tinkerius/brewberrypi-case/04-stl/README.md

# STL output

Generated by `tools/build.sh` from `03-openscad/brewberrypi-case.scad`. Do not edit by hand.
Checked by `tools/check.sh`. Full output: [check-report.txt](check-report.txt).

Built from spec version: **0.21** (2026-11-04: after the first print: jack hole Ø8.4 → Ø7.9, rocker switch cutouts MAIN 21 × 28.5, HEATER/PUMP 21.5 × 30. 2026-10-27: new brand: labels in Zilla Slab Bold, stacked brand logo centred on the top lid. 2026-10-23: all bought parts measured; M2.5 inserts for the circuit boards; adapter on 4 standoffs; Pi centred and turned: GPIO to the outer wall, USB/Ethernet back, SD card front; relay board in its original orientation under it).

## Files

| File | Part | Size (mm) | Print orientation (as exported) |
|---|---|---|---|
| [brewberrypi-case-body.stl](brewberrypi-case-body.stl) | body | 190 × 160 × 123 (+0.6 labels front/back) | upright, bottom edge on the bed |
| [brewberrypi-case-divider.stl](brewberrypi-case-divider.stl) | divider plate | 183.4 × 153.4 × 13 | upside down, standoffs and brackets pointing up |
| [brewberrypi-case-top_lid.stl](brewberrypi-case-top_lid.stl) | top lid | 186.6 × 156.6 × 3.8 | inner face on the bed, logo up (+0.8 logo) |
| [brewberrypi-case-bottom_lid.stl](brewberrypi-case-bottom_lid.stl) | bottom lid | 190 × 160 × 7 | outer face on the bed, lip up |

All parts are designed to print **without supports** in one filament. Everything else (material, layer height,
infill, …) is up to your slicer. Bought parts: see spec §7 (M3 inserts 3 × 6 × 4.5 + M3 screws for the case, M2.5 inserts 2.5 × 5 × 3.5 + M2.5 screws
for the Pi and relay board, brass M2.5 M/F Pi standoffs, 2 × M3 × 30 for the adapter, 4 rubber feet).

## Previews

| | iso (front) | iso (back) | top | front |
|---|---|---|---|---|
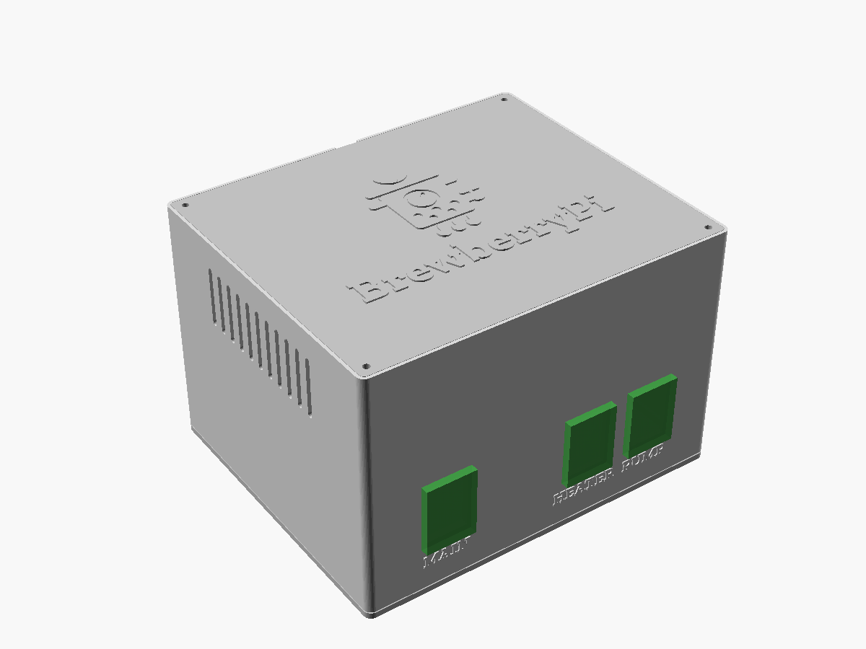
[picture p1: 04-stl/previews/assembly-iso.png]
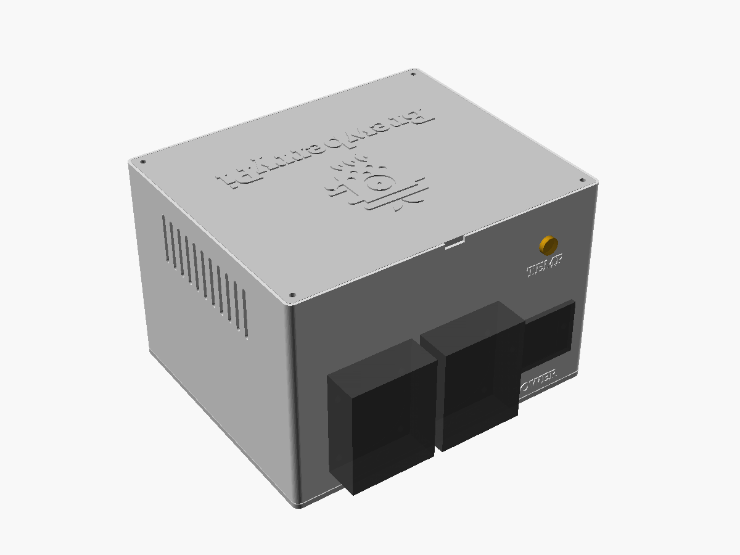
[picture p2: 04-stl/previews/assembly-iso-back.png]
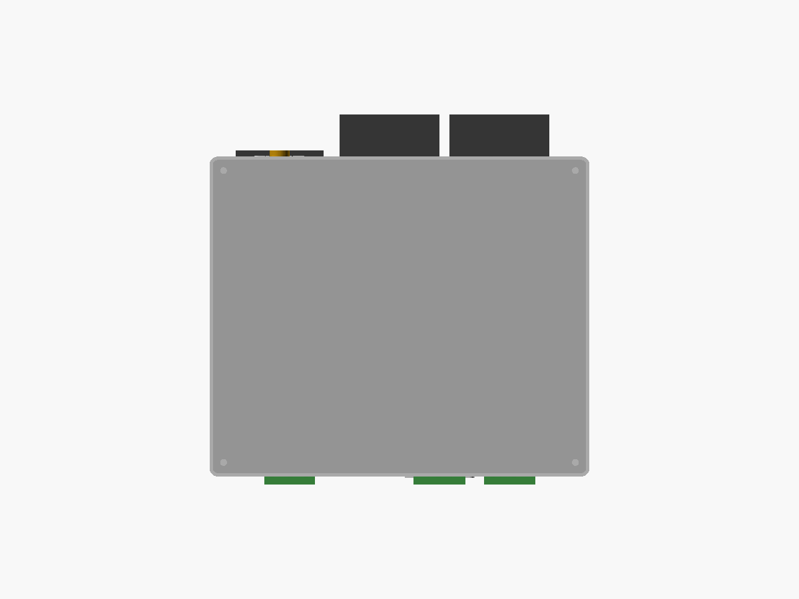
[picture p3: 04-stl/previews/assembly-top.png]
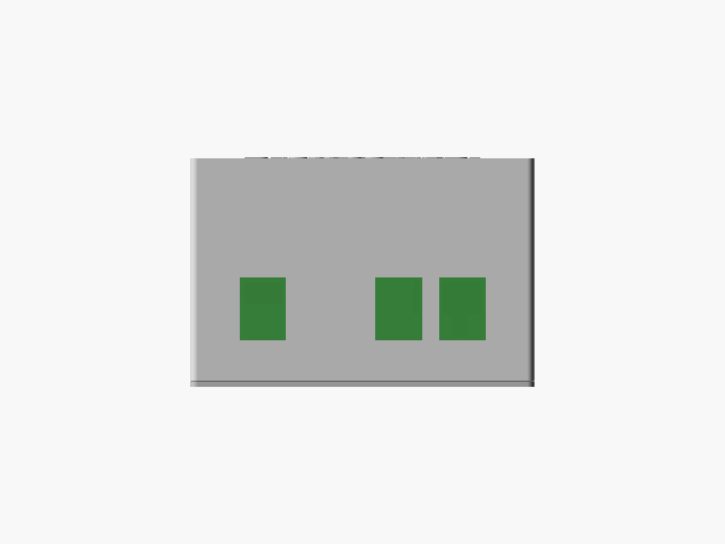
[picture p4: 04-stl/previews/assembly-front.png]
| assembly |  |  |  |  |
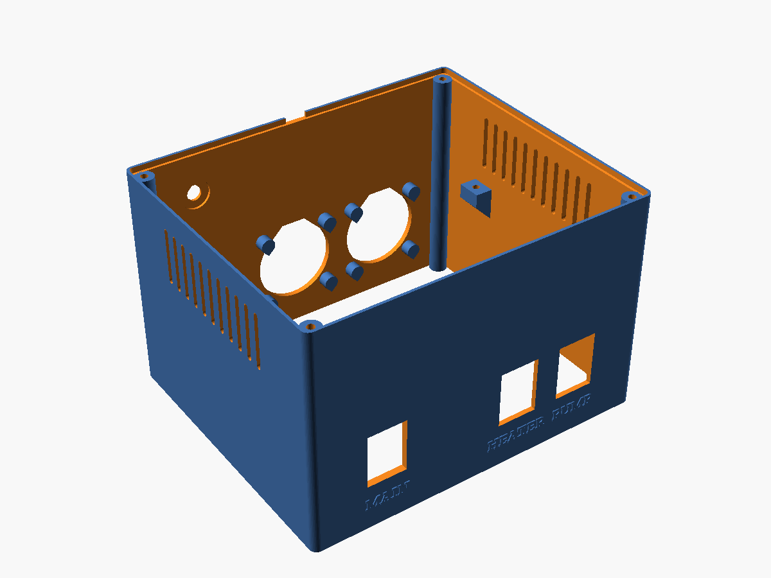
[picture p5: 04-stl/previews/body-iso.png]
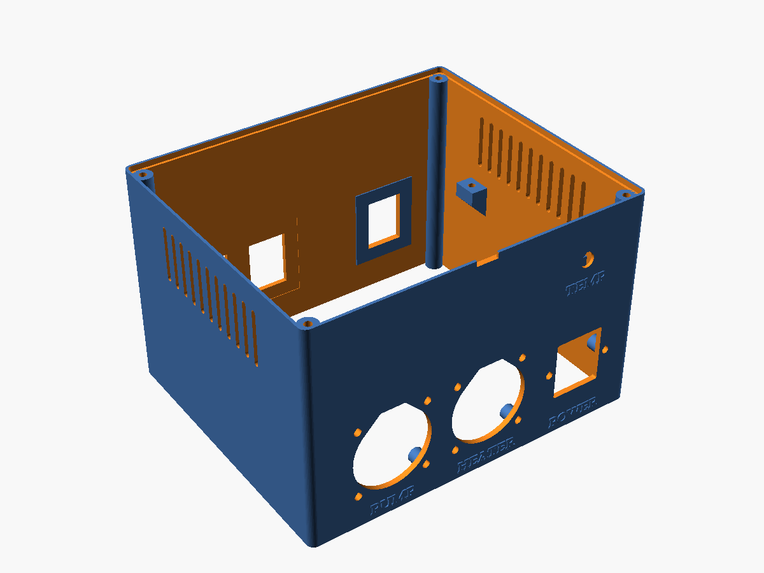
[picture p6: 04-stl/previews/body-iso-back.png]
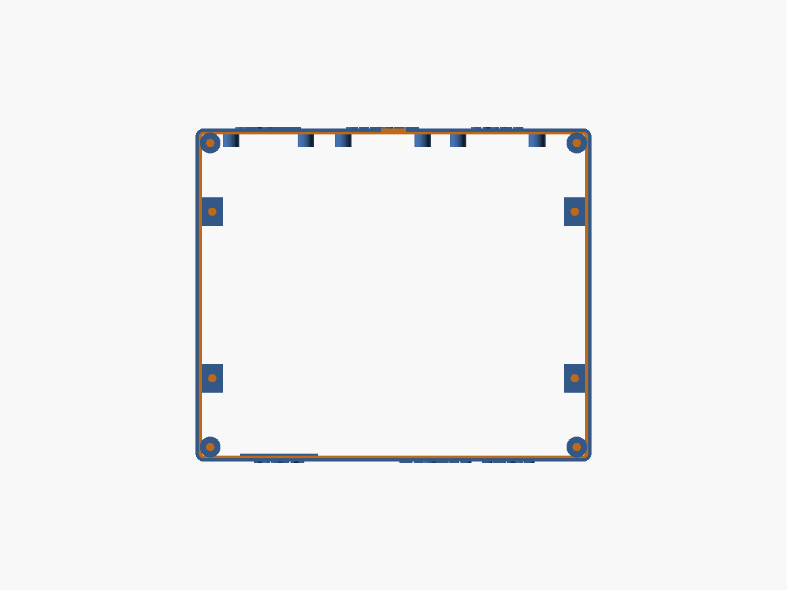
[picture p7: 04-stl/previews/body-top.png]
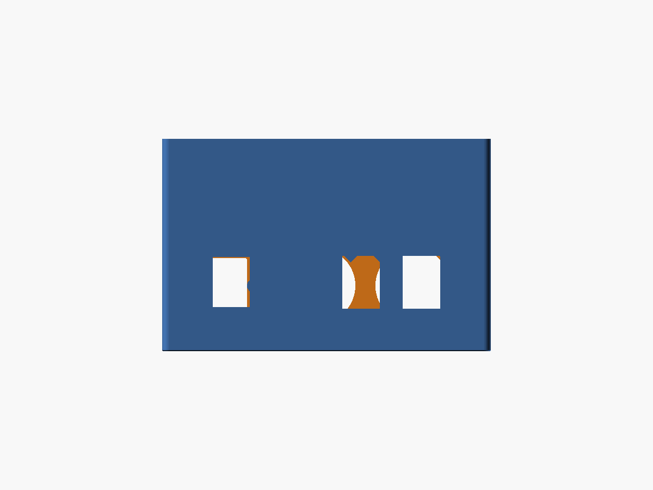
[picture p8: 04-stl/previews/body-front.png]
| body |  |  |  |  |
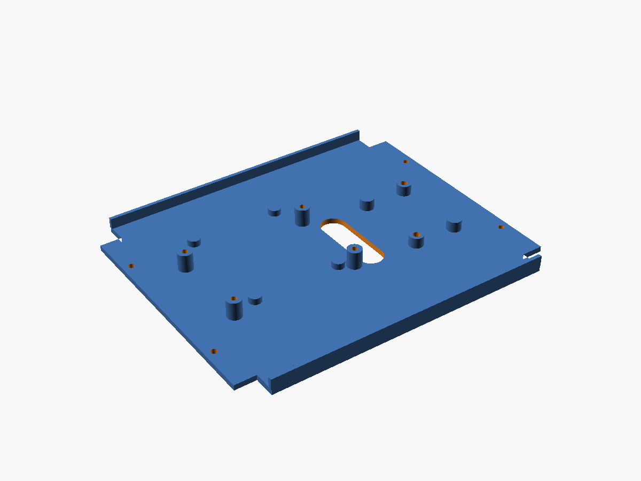
[picture p9: 04-stl/previews/divider-iso.png]
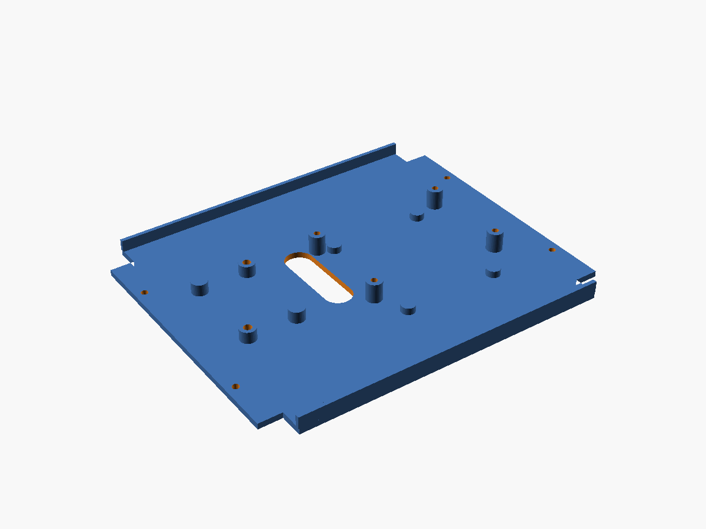
[picture p10: 04-stl/previews/divider-iso-back.png]
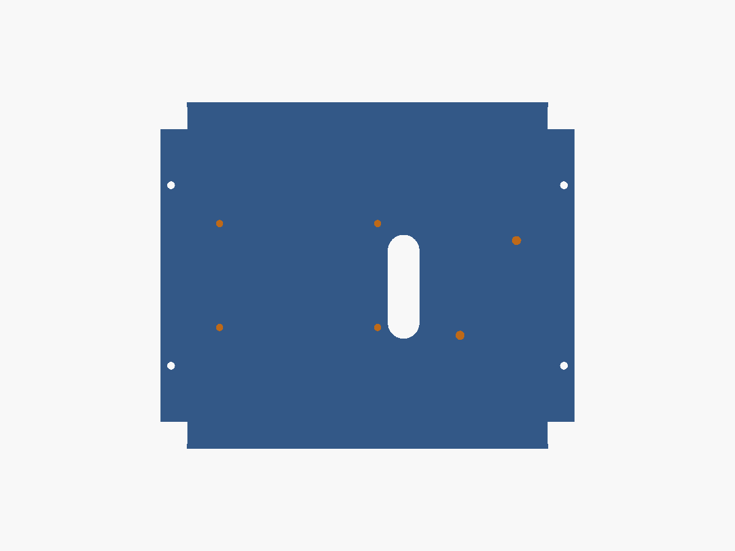
[picture p11: 04-stl/previews/divider-top.png]
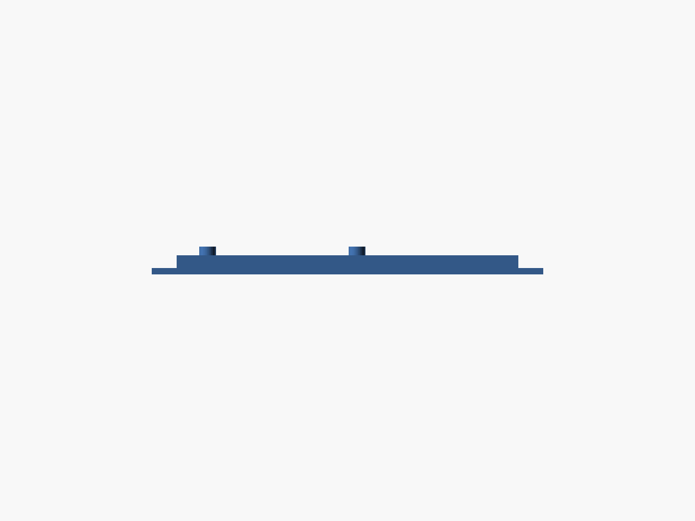
[picture p12: 04-stl/previews/divider-front.png]
| divider |  |  |  |  |
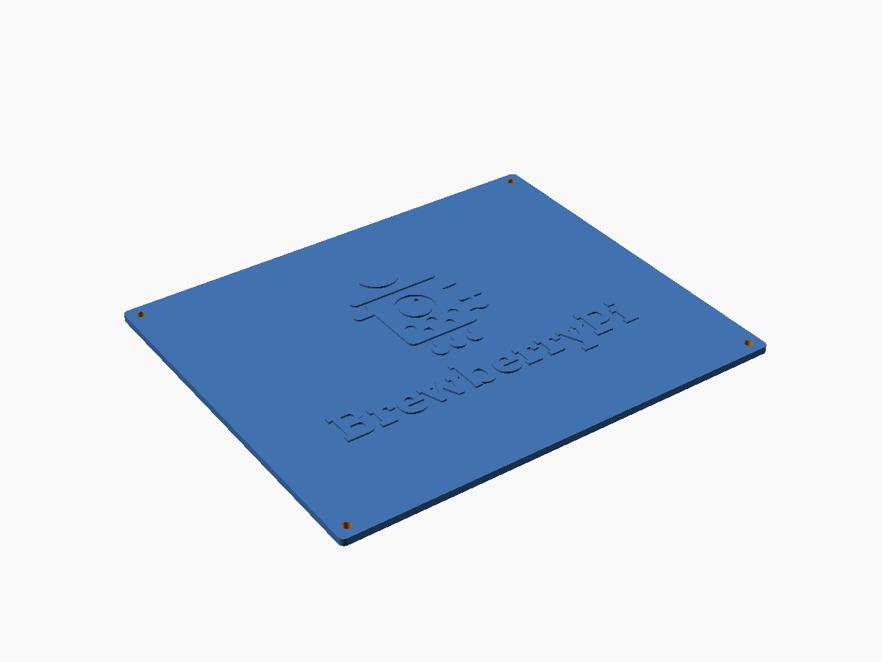
[picture p13: 04-stl/previews/top_lid-iso.png]
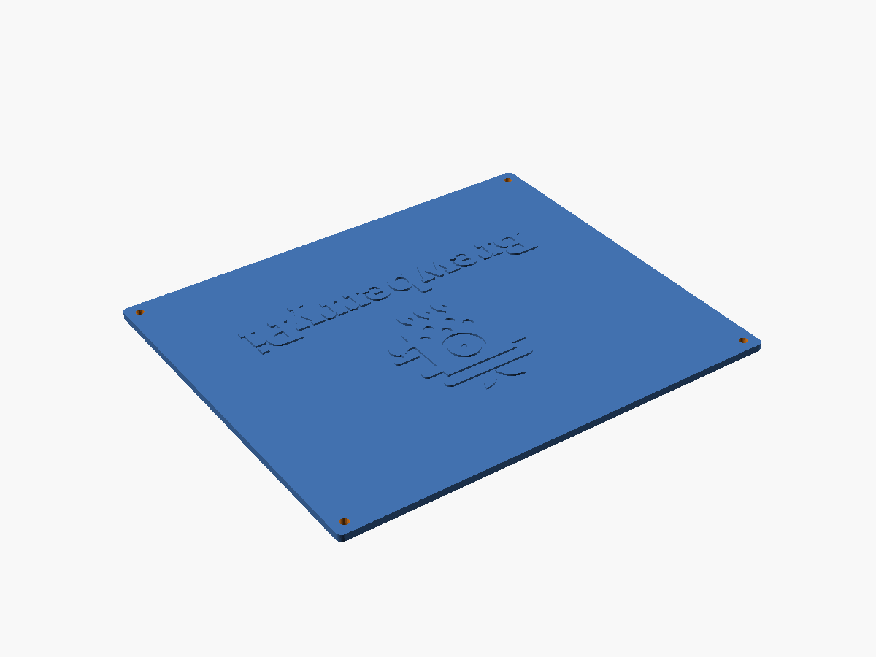
[picture p14: 04-stl/previews/top_lid-iso-back.png]
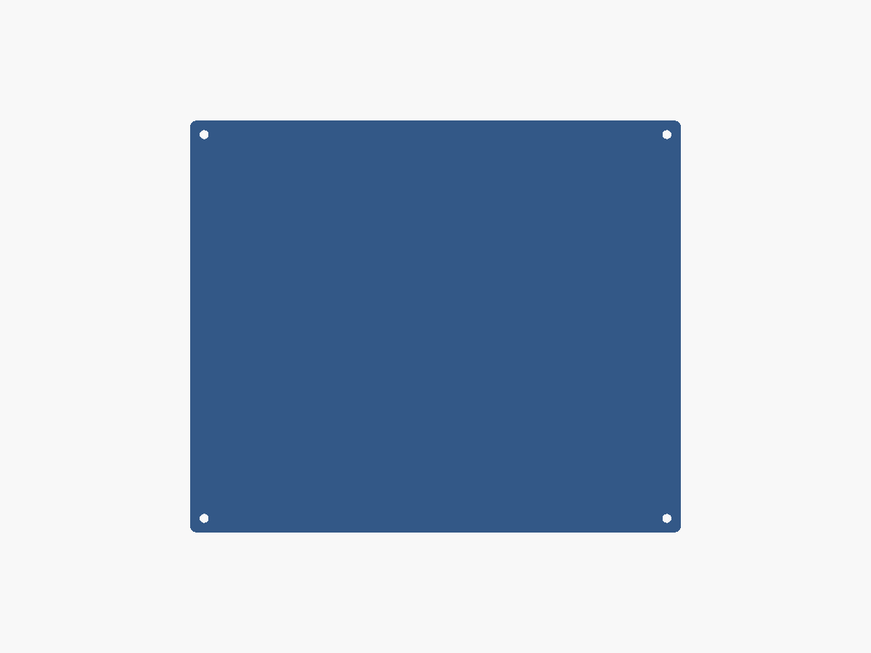
[picture p15: 04-stl/previews/top_lid-top.png]
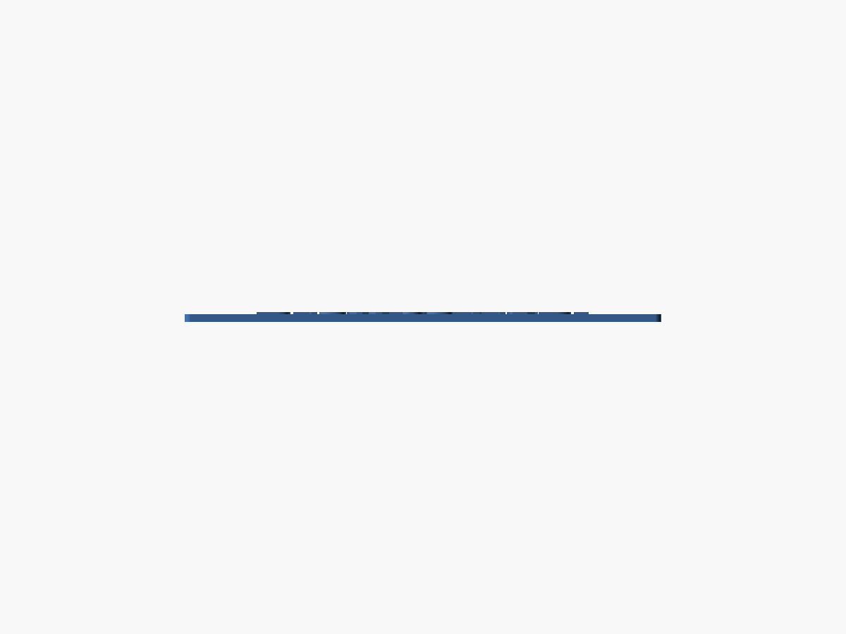
[picture p16: 04-stl/previews/top_lid-front.png]
| top lid |  |  |  |  |
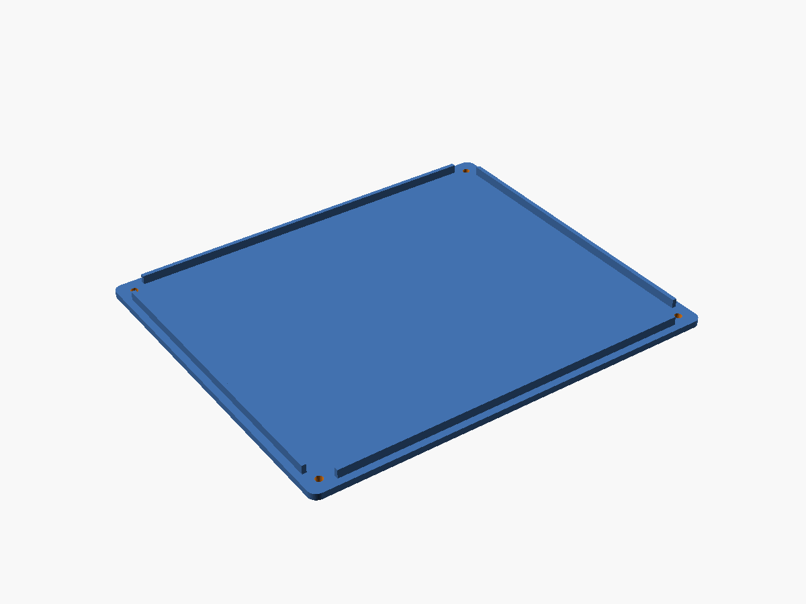
[picture p17: 04-stl/previews/bottom_lid-iso.png]
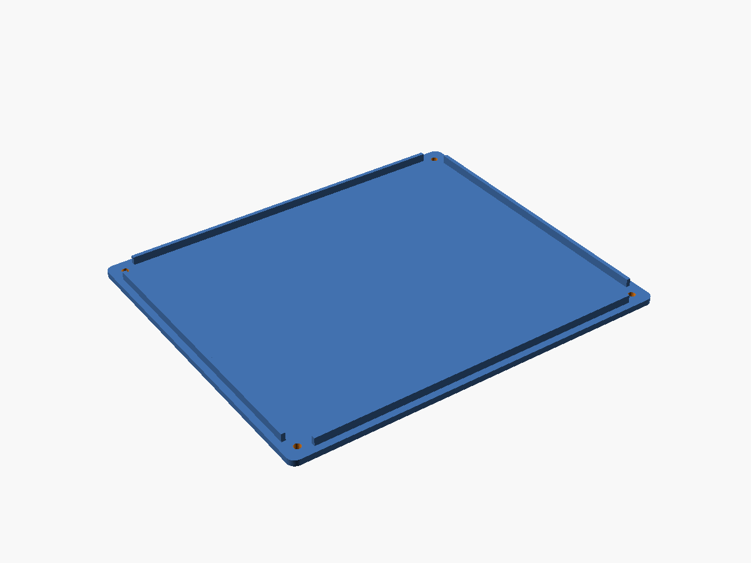
[picture p18: 04-stl/previews/bottom_lid-iso-back.png]
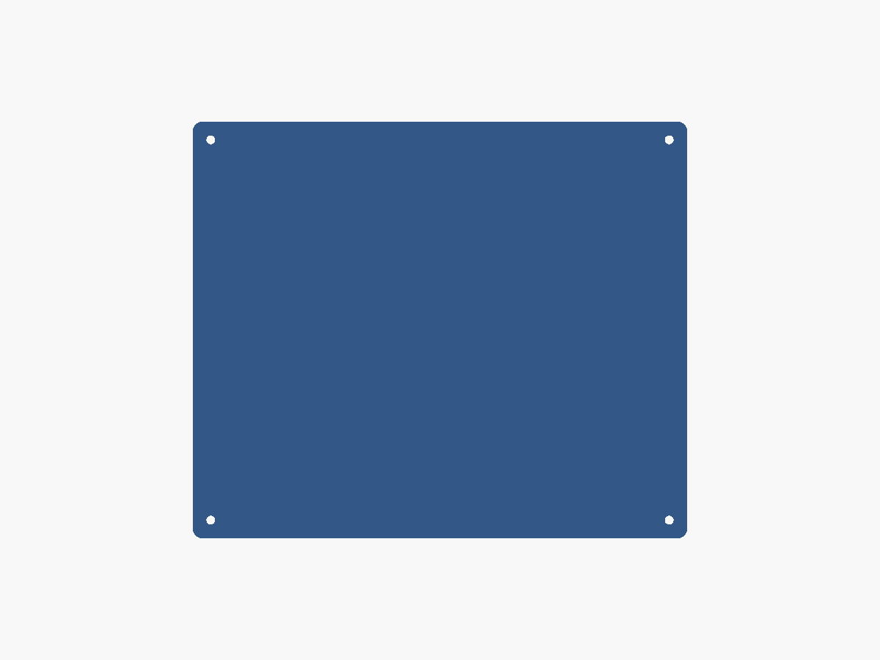
[picture p19: 04-stl/previews/bottom_lid-top.png]
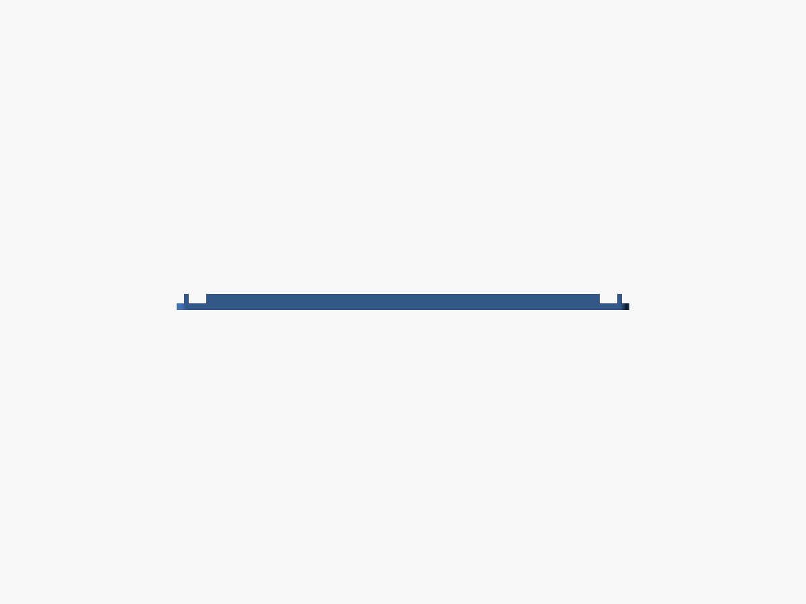
[picture p20: 04-stl/previews/bottom_lid-front.png]
| bottom lid |  |  |  |  |

## Verification (spec §9)

| AC | Criterion | Result | Evidence |
|---|---|---|---|
| AC1 | Bounding boxes ≤ 200 mm, sizes as in §1 | ✅ pass | all four sizes as in the table above (`check.sh`, admesh) |
| AC2 | Every STL manifold | ✅ pass | 1 part each, 0 degenerate facets, 0 edges fixed, 0 facets added/removed, 0 backwards edges |
| AC3 | No collision between components and printed parts | ✅ pass | `part="collision_check"` renders empty: 10 component envelopes against all printed parts and against each other (45 pairs) |
| AC4 | Cutouts as in §5 (F3, F6, F7, F8) | ✅ pass | model report: MAIN 21.4 × 28.9 (wall at the clips 3.7), HEATER/PUMP 21.9 × 30.4 (wall 2.7), the same measured on the STL's front face at x 40/115/150, z 40; IEC 27.9 × 31.9 r1 at x 35, z 38, screws 36; sockets Ø43.4 flat top at 24, HEATER x 90 / PUMP x 145, z 38, □38; jack Ø7.9 (thread 7.8 + 0.05 per side, P36; measured on the STL: 7.90 wide) flat top at 4.7, wall 1.6, at x 35, z 98; adapter on 4 standoffs: M3 inserts at (161, 64.5) and (136, 106.5), solid at (136, 64.5) and (161, 106.5), 25 × 42 apart. Seen from the top, both panels read mains, heater, pump from the left |
| AC5 | Pi pattern 58 × 49 at F11, relay pattern below | ✅ pass | Pi centred front to back, GPIO header on the left: holes (43.5/92.5, 41/99); relay board in its original orientation: holes 70 × 46 at (29.5/99.5, 57/103), under the Pi, 2 mm clear of the feed-through, standoffs separate from the Pi bosses. Collision check keeps 30 mm free at the SD card and at the USB/Ethernet ports (R23) |
| AC6 | No overhang > 45° without a bridge | ✅ pass | `overhangs.py`: body: bridges over the IEC cutout (27.9), switch cutouts (21.9/21.4), socket flat tops (13.4), jack flat top (≈1.8), insert-hole ceilings (Ø4), vent slot tops (Ø3); ledges ≤ 1.4 mm at the switch pockets/frame and the jack pocket; text undersides (0.6, now including the slab serifs: 191 tiny spots instead of 113). Divider: ceilings of the blind M2.5 insert holes (Ø3.2). Lids: none |
| AC7 | Only M3 and M2.5 fastener features | ✅ pass | code review: inserts `insert_m3` (Ø4.0 × 7, case) and `insert_m25` (Ø3.2 × 6, Pi + relay board), through holes `m3_clear` (Ø3.4) |
| AC8 | Labels raised 0.6 (logo 0.8), capitals ≥ 6 mm, all text in Zilla Slab Bold, readable from outside; logo 130 × 85.17 at (95, 80), same outline as B2 | ✅ pass | `labels.py`: capitals 6.05–6.23 mm (6.05 = 0.903 × 6.7, the Zilla Slab cap height; U/O/P overshoot gives the rest), raised 0.60; logo 130.00 × 85.17 mm, centre (95.00, 80.00), raised 0.80. Font: Zilla Slab Bold loaded from `03-openscad/fonts/`, slab serifs visible in body-iso / body-iso-back. Logo outline (`lib/brand-logo.scad`) rasterised over B2 at 10 px per unit: 363 of 236 872 pixels differ (0.15 %, edge anti-aliasing only); mask parts (dial ring, needle, berry dots) cut out. Back labels read correctly from behind (body-iso-back) |
| AC9 | Print test: lids, divider and components fit | ⏳ open | first print (2026-11-04): jack hole printed **8.5** (model Ø8.4) for the 7.8 mm thread, too loose → v0.20: Ø7.9. Rocker switch cutouts too small: MAIN fits the HEATER/PUMP height and was 1 mm too wide, HEATER/PUMP far too low → v0.21: MAIN 21 × 28.5, HEATER/PUMP 21.5 × 30. **Reprint the body** |
| AC10 | Lid joints: 0.2 clearance, flush | ✅ pass | collision check: top lid in the rim, bottom lid lip in the walls, divider on the pads: all empty. Top lid 186.6 × 156.6 = rim inner outline − 0.2 per side |

## Measured parts

All bought parts were measured on 2026-10-23 (interview round 10) and are in the model: relay board 75 × 52 (holes 70 × 46), USB-C adapter 51 × 49 × 27 with its screw hole, jack M8, switch clip gaps and bodies, inserts M3 3 × 6 × 4.5 (case) and M2.5 2.5 × 5 × 3.5 (circuit boards).
