tinkerius/brewberrypi-case/01-requirements/inputs/README.md

# Inputs

Photos, hand-drawn sketches, screenshots, datasheets and links provided for the requirements.

| ID | File | Provided | What it shows | Readable dimensions |
|---|---|---|---|---|
| S1 | [sketch-01-sectional-view.jpg](sketch-01-sectional-view.jpg) | 2026-10-19 | Section through the case. Upper **RPI part** with the Pi on standoffs on top of a horizontal divider; **relay board** on standoffs hanging *under* the divider in the lower **MAINS part**; **cable feed-through** in the divider (RPI ↔ MAINS, blue cable from Pi GPIO to relay board); **USB-C power adapter** in the MAINS part. Separate **RPI lid (top)** and **MAINS lid (bottom)**. | none, proportions only: upper compartment ≈ 40 % of the height |
| S2 | [sketch-02-front-view.jpg](sketch-02-front-view.jpg) | 2026-10-19 | Front face. Dashed line = divider / part boundary at ≈ 1/3 from the top. Below it, three rectangular cutouts: **main switch** (rocker, I/0) and **boiler + pump switches** (rocker, I/0/II). | none |
| S3 | [sketch-03-back-view.jpg](sketch-03-back-view.jpg) | 2026-10-19 | Back face. Above the dashed line: round cutout for the **3.5 mm jack socket (temperature sensor)**, top left. Below: rectangular cutout for the **power inlet** and two round cutouts with 4 screw holes each for the **power sockets (boiler, pump)**. | none |
| C1 | [component-C1-relay-board.png](component-C1-relay-board.png) | 2026-10-19 (re-sent) | 4-channel relay module, red PCB, 4 × SONGLE SRD-05VDC-SL-C, control terminals (IN1–IN4, DC−, DC+) along one long edge, NO/COM/NC terminals along the other, trigger jumpers, 4 corner holes. | none (size assumed, A1) |
| C2 | [component-C2-usb-c-adapter.png](component-C2-usb-c-adapter.png) | 2026-10-19 (re-sent) | USB-C PD adapter ZQ-P3020C with flying mains leads and WAGO 221 connectors. Inset photos show it mounted in wall/junction boxes. | 50 × 49 × 27 |
| C2b | [component-C2-usb-c-adapter-holes.png](component-C2-usb-c-adapter-holes.png) | 2026-10-23 | USB-C adapter held in a hand: the **two mounting holes**, top-right and bottom-left of the port face (diagonally opposite, symmetric). | – |
| C3 | [component-C3-jack-socket.png](component-C3-jack-socket.png) | 2026-10-19 (re-sent) | 3.5 mm panel jack: black round front nut with the 3.5 mm opening, silver hex nut behind it, black body with solder lugs. | overall length 20, front part 10, bore 3.5 |
| C4 | [component-C4-iec-inlet.png](component-C4-iec-inlet.png) | 2026-10-19 (re-sent) | IEC C14 inlet with fuse holder, screw-mount flange: dimensioned drawing (side, front, top, connection view) + product photos. | flange 43.8 × 32.8 × 3.1, holes Ø3.5 at 36.0, body 27 × 31.0, depth 27.6 |
| C5 | [component-C5-power-socket.png](component-C5-power-socket.png) | 2026-10-19 (re-sent) | Panel-mount earthed socket 16 A 2P+E with hinged cover: manufacturer drawing (front + side) with dimension table a–h. | a 50, b 38, c 62, d 25, e 21, f 26, g Ø43, h Ø4.5 |
| C6 | [component-C6-rocker-switch-2pos.png](component-C6-rocker-switch-2pos.png) | 2026-10-19 (re-sent) | Rocker switch I/0, illuminated, splash-proof boot: drawing (front, side, panel cutout) + product photos. | bezel 35.3 × 29, body 26 × 21.7, depth 15.1 + 10.2, cutout 27 × 22 |
| C7 | [component-C7-rocker-switch-3pos.png](component-C7-rocker-switch-3pos.png) | 2026-10-19 (re-sent) | Rocker switch I/0/II, illuminated, splash-proof boot: drawing (cutout, front, side) + product photos. | bezel 35 × ≈26.7 (scaled), body width 21, height 40.5, cutout 28.5 × 21.5 |
| B1 | [brand-logo-mono.svg](brand-logo-mono.svg) | 2026-10-27 | **BrewberryPi brand logo**, one colour, side by side: the kettle mark (lid with leaf knob, kettle body with 5 berry dots, dial thermometer with needle, ball valve, 3 flames) and the name "BrewberryPi" in **Zilla Slab Bold**, already as outlines. Copied unchanged from `tinkerius/brewberrypi` `brand/logo-mono.svg` (commit `0446c5e`), generated there by `brand/tools/build_brand.py`. The dial ring, needle and berry dots are **SVG masks**. Brand rules (from `brand/README.md`): no stretching, rotating or outlining; clear space ≥ ⅛ of the mark's height; never together with the Raspberry Pi logo. Typeface: Zilla Slab (SIL OFL 1.1), `google/fonts` `ofl/zillaslab/`. Proposed in the v0.19 draft, replaced by B2. | brand units: mark on a 64 × 64 grid, drawn part 285.85 × 58.60 (x 8…293.85, y 3.5…62.10), name capitals 25.35 |
| B2 | [brand-logo-stacked.svg](brand-logo-stacked.svg) | 2026-10-27 | **BrewberryPi brand logo, stacked** ("for square spaces"): the same kettle mark as B1, centred above the name "BrewberryPi" (Zilla Slab Bold, outlines), everything centred. Copied unchanged from `tinkerius/brewberrypi` `brand/logo-stacked.svg` (commit `0446c5e`). Exists only in colour (light background); the shapes are those of the one-colour version, so colour plays no part in a one-filament print. Same SVG masks as B1. **Used on the top lid since spec v0.19.** | brand units: viewBox 142.496 × 94, drawn part 133.12 × 87.21 (x 4.94…138.06, y 3.5…90.71), mark 52 wide (64 grid, moved 39.25 right), name capitals 15.6 |

> To keep the originals, add them here as `component-C1-relay-board.jpg` etc.
