tinkerius/brewberrypi-case/02-specification/spec.md

# Specification: BrewberryPi Case

| Version | Status | Approved by / date |
|---|---|---|
| 0.21 | **approved** (requested by the user) | user (tinkerius), 2026-11-04: rocker switch cutouts, print feedback change 2 |
| 0.20 | **approved** (requested by the user) | user (tinkerius), 2026-11-04: "let's make the hole 0.5mm smaller" |
| 0.19 | **approved** | user (tinkerius), 2026-10-27: stacked brand logo ("Perfect. Take this. Merge!") |
| 0.18 | **approved** (requested by the user) | v0.3: user (tinkerius), 2026-10-19 · v0.4 confirmed 2026-10-19 · v0.5–v0.8 requested 2026-10-22 · v0.9 measured, v0.10–v0.18 2026-10-23 |

Traces to `01-requirements/requirements.md` (R…, A…) and `01-requirements/inputs/components.md` (C…).

## 1. Overview

A table-top box, **190 × 160 × 126 mm**, split horizontally into two compartments (R2):

- **Low-voltage part (top):** Raspberry Pi on the divider plate, temperature-sensor jack at the back.
- **High-voltage part (bottom):** relay board hanging under the divider plate **directly below the Pi**, USB-C power adapter hanging **next to it**, 3 rocker switches at the front, IEC power inlet + 2 power sockets at the back.

All electronics except the panel components sit on the **divider plate**, which comes out as one module. The bottom lid carries no components.

Both lids **interlock with the body** (R22): the top lid sits in a rebate inside a rim on the wall top, and the bottom lid has a locating lip that reaches inside the walls. The lids can't slide or twist, and the screws only clamp.

Four printed parts (R16), all printed **without supports**, in one filament (R13):

| # | Part | `part=` | Size (mm) | Print orientation |
|---|---|---|---|---|
| 1 | Body (walls, no floor/ceiling) | `body` | 190 × 160 × 123 | upright, bottom edge on the bed |
| 2 | Divider plate | `divider` | 183.4 × 153.4 × 13 | **upside down** (standoffs and fence pointing up) |
| 3 | Top lid | `top_lid` | 186.6 × 156.6 × 3.8 | outer face up (raised logo on top) |
| 4 | Bottom lid | `bottom_lid` | 190 × 160 × 7 | outer face down (lip pointing up) |

Every part fits within 200 × 200 × 200 mm (R21).

## 2. Coordinate system

- Units: mm.
- Origin: **front-left-bottom outer corner of the body** (the bottom lid is below z = 0).
- +X to the right (seen from the front), +Y to the back, +Z up.
- Z levels: bottom lid −3…0 (lip up to z = 4) · high-voltage part 0…70 · divider plate 70…73 · low-voltage part 73…120 · top lid 120…123 (inside the rim, flush with it).

## 3. Drawings

| Drawing | Shows |
|---|---|
| [front-view.svg](drawings/front-view.svg) | switch cutouts, labels, overall size |
| [back-view.svg](drawings/back-view.svg) | IEC inlet, 2 sockets, jack, labels, pry notch (mirrored X) |
| [plan-view.svg](drawings/plan-view.svg) | divider layout: Pi (top) stacked over the relay board (below), adapter (below), feed-through, pads, columns, section lines |
| [section-a-a.svg](drawings/section-a-a.svg) | section through the Pi/relay stack, MAIN switch, PUMP socket: heights and clearances |
| [section-b-b.svg](drawings/section-b-b.svg) | section through the adapter, PUMP switch, IEC inlet |
| [section-c-c.svg](drawings/section-c-c.svg) | front section (viewed from the front) through the Pi/relay stack, feed-through and adapter |
| [detail-joints.svg](drawings/detail-joints.svg) | details X and Y (scale 5:1): top lid rebate and bottom lid lip |
| [top-lid.svg](drawings/top-lid.svg) | top lid from above: logo size and position, screw holes, optional fan mount |

Generated by `tools/make_drawings.py` from the same numbers as this spec.

## 4. Parameters (Customizer)

| ID | Name | Default | Range / notes | Used by |
|---|---|---|---|---|
| P1 | `case_w` | 190 | outer width X | all |
| P2 | `case_d` | 160 | outer depth Y | all |
| P3 | `hv_h` | 70 | high-voltage part: body bottom → divider underside | F1, F10 |
| P4 | `lv_h` | 47 | low-voltage part: divider top → top lid underside | F1 |
| P5 | `wall` | 3 | 2.4–4 | F1 |
| P6 | `lid_t` | 3 | 2.4–4 (also the rim height) | F15, F20, F30 |
| P7 | `divider_t` | 3 | 2.4–4 | F10 |
| P8 | `corner_r` | 4 | outer vertical edge radius | F1, F20, F30 |
| P9 | `fit_clearance` | 0.2 | 0.1–0.5, per side, added to every cutout (except the jack: P36) and mating fit | all cutouts, F10, F14, F15, F33 |
| P10 | `switch_panel_t` | [3.7, 2.7] | local wall thickness at the rocker switches [MAIN, HEATER/PUMP] = measured clip gap − 0.3. > `wall`: inside frame, < `wall`: inside pocket | F3 |
| P11 | `insert_m3` | [4.0, 7.0] | hole Ø, hole depth for the M3 heat-set inserts (3 × 6 × 4.5: 6 long, Ø4.5): case, lids, divider, panel parts | all M3 |
| P12 | `insert_m25` | [3.2, 6.0] | hole Ø, hole depth for the M2.5 heat-set inserts (2.5 × 5 × 3.5: 5 long, Ø3.5): circuit boards | F11, F12 |
| P13 | `pi_pos` | [40, 37.5] | corner (x, y) of the Pi's footprint 56 × 85, centred front to back; board turned so the **GPIO header is on the left** (outer wall), power socket right (feed-through), USB/Ethernet to the back, SD card to the front | F11 |
| P14 | `pi_holes` | [58, 49] | Pi hole pattern (same for Pi 3/4/5) | F11 |
| P15 | `relay_board` | [75, 52] | **measured** | F12 |
| P16 | `relay_holes` | [70, 46] | **measured**, Ø3 | F12 |
| P17 | `relay_pos` | [27, 54] | corner (x, y) of the relay board (75 × 52, original orientation), under the Pi, 2 mm clear of the feed-through | F12 |
| P18 | `relay_standoff_h` | 10 | gap between divider and relay PCB | F12 |
| P19 | `adapter` | [51, 49, 27] | USB-C adapter size, **measured** (C2) | F14 |
| P20 | `fan` | 0 | 0 = none, 30 or 40 = fan mount in the top lid | F22 |
| P21 | `labels` | true | raised labels on/off | F5, F8, F21 |
| P22 | `label_raise` | 0.6 | label height above the surface | F5, F8 |
| P23 | `switch_main` | cutout [21, 28.5] | C6, portrait (w × h), from the print test (round 20) | F3 |
| P24 | `switch_3pos` | cutout [21.5, 30] | C7, portrait (w × h), from the print test (round 20) | F3 |
| P25 | `iec_cutout` | [27.5, 31.5, r1], screws 36 | C4 | F6 |
| P26 | `socket_cutout` | Ø43, holes □38 | C5 | F7 |
| P27 | `jack_d` | 7.8 | C3 thread (M8), **measured** 7.8 (round 20) | F8 |
| P28 | `jack_panel_t` | 1.6 | local wall thickness at the jack: hex nut 2 + wall 1.6 ≤ 4 mm usable thread. ≥ `wall` → no thinning | F8 |
| P29 | `adapter_pos` | [123, 61] | adapter corner (x, y) | F14 |
| P30 | `adapter_holes` | [[38, 3.5], [13, 45.5]] | the adapter's two mounting holes (diagonal, 25 × 42 apart), relative to the adapter corner (x from the cable side, y from the front), **measured** | F14 |
| P34 | `adapter_standoff_h` | 6 | gap between divider and adapter; M3 × 30 = 22 through the adapter + 8 into standoff and plate | F14 |
| P31 | `rim_t` | 1.5 | 1.2–2, outer part of the wall that rises above the lid seat (top rebate) | F15, F20 |
| P32 | `lip` | [2, 4] | thickness, height of the bottom lid's locating lip | F33 |
| P35 | `logo_w` | 130 | width of the logo's drawn area; the height follows the brand proportions (× 87.21 / 133.12 → 85.17) | F21 |
| P36 | `jack_clearance` | 0.05 | per side, the jack hole's own clearance instead of P9: with P9 the hole (Ø8.4) printed at 8.5 and the jack sat loose → hole Ø7.9 | F8 |

## 5. Features

**Typeface (R24):** all text on the case is set in the brand typeface **Zilla Slab Bold** (SIL Open Font License). The font file ships with the model, so the case renders the same without the font installed.

### 5.1 Body (`part="body"`)

| ID | Feature | Dimensions / position | Traces to |
|---|---|---|---|
| F1 | Shell | 190 × 160 × 123, wall 3, vertical edges R4, open top and bottom. Outer bottom edge chamfer 0.6 | R2, R13 |
| F2 | Corner columns | 4 × Ø10, from z = 0 to the lid seat (z = 120), centres 7 mm from the outer faces. M3 inserts **top and bottom** (lid screws) | R11, R12 |
| F3 | Front switch cutouts | Order from the left, seen from the top: MAIN, HEATER, PUMP. Centre z = 40. MAIN (C6) at x = 40: **21 × 28.5**. HEATER (C7) at x = 115 and PUMP (C7) at x = 150: **21.5 × 30**. Portrait. Sizes from the print test (round 20): the datasheet cutouts were too low. Wall at the clips = clip gap − 0.3 (P10), 8 mm around each cutout: MAIN **3.7 mm** (0.7 mm frame on the inside), HEATER/PUMP **2.7 mm** (0.3 mm pocket on the inside) | R6 |
| F4 | Divider pads | 4 pads 10 × 14 on the left/right inner walls, centres (8, 40), (8, 120), (182, 40), (182, 120). Top at z = 70, 45° chamfer underneath. M3 insert from the top | R16 |
| F5 | Front labels (raised) | "MAIN", "HEATER", "PUMP", capitals 6 mm in **Zilla Slab Bold**, centred under each switch, baseline z = 12 | R20, R24 |
| F6 | Back: IEC inlet (C4) | Order from the left, seen from the top: POWER, HEATER, PUMP (same as the switches). Centre x = 35, z = 38. Cutout 27.5 × 31.5 r1 (the inlet body has r1 corners on one side, C4). 2 screw holes at x ± 18 with **M3 inserts pressed in from outside** into bosses on the inside | R7 |
| F7 | Back: 2 power sockets (C5) | HEATER at x = 90, PUMP at x = 145, centre z = 38. Ø43 cutout, **flat-top teardrop** (flat at r = 24, hidden under the 50 mm flange). 4 screw holes on a 38 mm square, M3 inserts from outside (M3 + washer in the socket's Ø4.5 holes) | R7 |
| F8 | Back: jack (C3) | x = 35, z = 98 (above the power inlet). **Ø7.9** **flat-top teardrop** (thread 7.8 + 2 × P36 0.05), flat at 4.7 mm above the centre (hidden under the Ø10 nose). Inside pocket Ø16 thins the wall to P28 (1.6 mm) for the 11 mm hex nut. Raised labels "POWER", "HEATER", "PUMP" (baseline z = 4) and "TEMP" (baseline z = 82), capitals 6 mm in **Zilla Slab Bold**, readable from the back | R8, R20, R24 |
| F9 | Vent slots | Left and right walls, low-voltage part only: 11 slots 3 × 30 (rounded), z = 80…110, y = 40…120, pitch 8 | A7 |
| F15 | Top rebate (lid seat) | The inner 1.5 mm of the wall ends at z = 120 (**lid seat**, together with the column tops). The outer **rim** (P31, 1.5 mm) continues to z = 123. The top lid drops into the rim and sits flush with it | R22 |
| F16 | Pry notch | Rim cut down to the lid seat over 12 mm, centred on the back wall (x = 95), so a fingernail or screwdriver can lift the top lid | R22 |

### 5.2 Divider plate (`part="divider"`)

| ID | Feature | Dimensions / position | Traces to |
|---|---|---|---|
| F10 | Plate | Inner body outline minus 0.3 per side = 183.4 × 153.4 × 3, corners notched 12 × 12 for the columns. 4 × Ø3.4 holes over the pads. Stiffening ribs 2 × 6 on the **underside** along the front and back edges (x = 15…175) | R2, R16 |
| F11 | Pi mount (top side) | Pi 85 × 56, footprint 56 × 85 at (40, 37.5), **centred front to back** (R23). Turned so the **GPIO header runs along the left edge** (x ≈ 41–46, outer wall side, 37 mm to the wall), the **power socket faces the feed-through** (right edge), the **USB/Ethernet ports face the back** and the **SD card the front**, each with **34.5 mm free**. 4 **M2.5 inserts** (P12) at (43.5, 41), (92.5, 41), (43.5, 99), (92.5, 99), pressed in from the top face into Ø7 bosses that protrude 3.5 mm **under** the plate. The Pi sits on **brass M2.5 hex standoffs, 10 mm, male-female** (bought), male end screwed into the inserts | R3, R9, R12, R18, R23 |
| F12 | Relay board mount (underside) | Board 75 × 52 (P15) in its **original orientation** (long side along X) at (27, 54), **under the Pi** (sticks out ≈ 10 mm on each side), 2 mm clear of the feed-through. 4 printed standoffs Ø8 × **10** at the 70 × 46 hole pattern (P16): (29.5, 57), (99.5, 57), (29.5, 103), (99.5, 103), with **M2.5 inserts** (P12); M2.5 screws through the board's Ø3 holes. **Relay terminals (NO/COM/NC) to the back** (towards the sockets), control terminals (IN1–4, DC±) to the front. Relays face down (17 mm incl. PCB); screw terminals are reachable from below | R3, R12 |
| F13 | Cable feed-through | Rounded slot 14 × 46 centred at (111, 85), between the stack and the adapter, next to the Pi's power socket. Carries the USB-C cable (short, straight up to the power socket) and the GPIO jumper wires (from the header on the Pi's left edge, about 7 cm) | R4 |
| F14 | Adapter mount (underside) | Adapter 51 × 49 at (123, 61), **USB-C port face down**, cable side towards −X (feed-through). **Orientation:** with the port face down, the port face's **top edge points to the front (−Y)**, so its top-right hole is at front-right and its bottom-left hole at back-left; the USB-C port (near the bottom edge) is towards the back. Sits on **2 printed standoffs Ø8 × 6** (P34) under the holes at **(161, 64.5)** and **(136, 106.5)**, 25 × 42 mm apart (P30), each with an **M3 insert** pressed in from the tip (hole Ø4.0 × 8.5), plus **2 solid rest standoffs** (same size, no insert) at the other two corners of the 25 × 42 rectangle, **(136, 64.5)** and **(161, 106.5)**: the adapter rests on 4 points. Fixed with **2 × M3 × 30** from below, heads in the adapter's 5 mm recesses. Two diagonal screws stop it turning: no brackets, no tie slots, no nut | R5 |

Swapping to a Pi 4/5 (R18): same hole pattern, so normally nothing changes. If a different layout is ever needed, only this part is reprinted.

### 5.3 Top lid (`part="top_lid"`)

| ID | Feature | Dimensions / position | Traces to |
|---|---|---|---|
| F20 | Plate | Rim inner outline minus 0.2 per side = **186.6 × 156.6 × 3**, corners R2.3, offset 1.7 from the body's outer faces. 4 × Ø3.4 holes over the corner columns (at 7 mm from the body's outer faces) | R11, R22 |
| F21 | Logo (raised) | **Brand logo, stacked** (B2): kettle mark centred above the name "BrewberryPi" (Zilla Slab Bold, outlines from B2), in one colour. Drawn area **130 × 85.17** (P35; kettle 50.8 × 57.2, name capitals 15.2), **centred on the lid** at (95, 80) (x 30…160, y 37.4…122.6), reading from the front, raised 0.8. The masked parts of B2 (dial ring, needle, 5 berry dots) are cut out of the raised area, down to the lid surface. The outline is converted from B2 by `tools/make_logo.py`, not redrawn: same shapes and proportions. ≥ 28 mm to the lid edge (brand clear space ≥ 7.2), clear of the screw holes. With the optional fan mount (F22) on, its opening and holes cut through the logo | R20, R24 |
| F22 | Fan mount (optional, P20) | Ø(fan − 2) opening + 4 × Ø3.4 holes (24 / 32 mm square for 30 / 40 mm fans), centred over the Pi SoC at (64, 67.5). Off by default. When on, it cuts through the logo (F21) | R18, A7 |

### 5.4 Bottom lid (`part="bottom_lid"`)

| ID | Feature | Dimensions / position | Traces to |
|---|---|---|---|
| F30 | Plate | 190 × 160 × 3, corners R4, 4 × Ø3.4 holes under the corner columns. No components (R5) | R11 |
| F33 | Locating lip | 2 thick × 4 high (P32) on the inner face, 0.2 inside the walls (lip from 3.2 to 5.2 mm from the outer edge). Interrupted at the corner columns: segments x = 12.5…177.5 along front/back, y = 12.5…147.5 along left/right | R22 |
| F32 | Feet positions | 4 adhesive rubber feet at (20, 20), (170, 20), (20, 140), (170, 140) on the outside. No geometry (positions avoid the lid screws) | R19 |

## 6. Interfaces & clearances

| Interface | Design value |
|---|---|
| All component cutouts | nominal datasheet cutout + P9 (0.2) per side. Jack: measured thread 7.8 + P36 (0.05) per side = Ø7.9 |
| Divider plate ↔ body inner walls | 0.3 per side |
| Top lid ↔ body | lid inside the rim with 0.2 per side, resting on the 1.5 mm seat + column tops, flush with the rim top. 4 × M3 screws into the columns |
| Bottom lid ↔ body | outer edges flush. Lip inside the walls with 0.2 per side, 4 mm deep. 4 × M3 screws into the columns |
| Pi underside ↔ divider | 10 mm (brass standoffs) |
| Pi bosses (3.5 mm under the plate) ↔ relay solder pins (3 mm) | 3.5 mm (relay standoffs 10 mm) |
| Relay PCB ↔ divider underside | 10 mm (P18). Relays hang 27 mm (down to z = 43) |
| Relay board ↔ front switch backs (incl. connectors) · adapter ↔ switch backs | ≥ 17 mm · ≥ 13 mm (Y) |
| Relay board ↔ IEC / HEATER socket bodies · adapter ↔ PUMP socket body | ≥ 26 mm · ≥ 21 mm (Y) |
| Adapter USB-C port ↔ bottom lid | 37 mm free below the adapter for the plug and cable bend (adapter z = 37…64) |
| Free height above the Pi board · free space in front of its USB/Ethernet ports and behind its SD card | ≈ 35 mm · 34.5 mm each |
| Hanging parts ↔ divider pads | relay x 27…102 and adapter x 123…174 lie between the pads (x ≤ 13 / ≥ 177) → the module can be lowered from the top |
| Bottom lid lip ↔ inside features | nothing on the inner walls below z = 9 except the corner columns, which the lip skips |

## 7. Hardware (bought parts)

| Item | Qty | Used for |
|---|---|---|
| M3 heat-set insert 3 × 6 × 4.5 (hole Ø4.0 × 7; adapter standoffs × 8.5) | 24 | corner columns 8, divider pads 4, sockets 8, IEC 2, adapter 2 |
| M3 × 8 button head (ISO 7380) | 12 | top lid 4, bottom lid 4, divider 4 |
| M3 × 10 button head + M3 washer | 10 (+8 washers) | sockets 8 (with washers), IEC 2 |
| M2.5 heat-set insert 2.5 × 5 × 3.5 (hole Ø3.2 × 6) | 8 | Pi 4, relay standoffs 4 |
| M2.5 brass hex standoff **M/F** 10 mm + M2.5 × 6 screw | 4 + 4 | Pi |
| M2.5 × 6 screw | 4 | relay board |
| Adhesive rubber feet, ≥ 3 mm high | 4 | bottom lid |
| (optional) M3 × 16 + nut | 4 | fan |
| M3 × 30 (cap or button head) | 2 | USB-C adapter |

Two thread sizes only: **M2.5 for the circuit boards** (Pi, relay board), **M3 for everything else** (R12, A4).

## 8. FDM design-rule check

| Rule (docs/fdm-design-rules.md) | How it is met |
|---|---|
| 1 Flat build-plate face | Body: bottom edge. Divider: top face (printed upside down). Top lid: inner face. Bottom lid: outer face |
| 2 Overhangs ≤ 45° or bridged | Pads and panel bosses: 45° chamfers underneath. Rectangular cutouts: top edge bridges ≤ 28.5 mm. Switch and jack pockets: ≤ 1.4 mm step. MAIN switch frame: 0.7 mm ledge.  Rim (F15) and lip (F33) grow straight up from their part |
| 3 Horizontal holes teardrop / flat-top | Sockets: flat-top teardrop. Jack: teardrop. Vent slots: rounded vertical slots (3 mm bridge) |
| 4 Bottom edges chamfered | Body outer bottom edge 0.6 chamfer. Lids are flat plates |
| 5 No floating islands | All features grow from the bed face |
| 6 Walls | `wall` = 3, ribs/lip ≥ 2, rim 1.5 (only 3 mm tall). Logo details below 1 mm: cosmetic, see below |
| 7 Mating fits | P9 `fit_clearance` |
| 9 Screw holes | M3 and M2.5 heat-set inserts, Ø3.4 through holes |
| 10 Manifold | checked by `tools/check.sh` |

Smallest details: labels 6 mm capitals (strokes ≥ 1 mm), slots 3 mm wide, rim 1.5 mm. No structural features below 1.5 mm (R13).

Exception, cosmetic only: the logo (F21) keeps the brand's fine details (R24). Gaps between the letters of the name ≥ 0.77 mm. In the kettle: a 0.88 mm wall between the dial ring and the middle berry dot, 0.98 mm gaps between leaf and lid and between valve handle and kettle; everything else ≥ 1.35 mm. They are 0.8 mm high on the lid's top face. If a slicer merges or drops one of them, the logo still reads, and nothing else changes.

## 9. Acceptance criteria

| ID | Criterion | How checked |
|---|---|---|
| AC1 | Each part's bounding box ≤ 200 × 200 × 200 mm, and matches the sizes in §1 | `tools/check.sh` bounding boxes |
| AC2 | Every STL is manifold (no repairs needed) | `tools/check.sh` |
| AC3 | Assembly: no collision between the component envelopes (Pi + standoffs, relay board + relays, adapter + plug space, 3 switches, 2 sockets, IEC inlet, jack) and the printed parts or each other | OpenSCAD `intersection()` of envelopes and parts is empty (debug render) |
| AC4 | Cutout sizes and positions match §5 (F3, F6, F7, F8) within ±0.1 mm | echo values in the model + front/back preview renders |
| AC5 | Pi hole pattern 58 × 49 at the F11 positions, relay pattern from P16 directly below | echo values + plan render |
| AC6 | No overhang > 45° without a bridge in the print orientation | inspection of the preview renders per part |
| AC7 | Only M3 and M2.5 fastener features | code review of insert/hole modules |
| AC8 | Labels raised 0.6 (logo 0.8), capitals ≥ 6 mm, all text in Zilla Slab Bold, readable from the outside (back labels not mirrored). Logo 130 × 85.17 (±0.1) centred at (95, 80), same outline as B2 | `labels.py` (capitals, raise, logo size and position) + preview renders + the flattened logo overlaid on B2 |
| AC9 | Print test: lids, divider and all components fit (user feedback after printing) | user |
| AC10 | Joints: the top lid clears the rim and the bottom lid lip clears the walls and columns by 0.2 per side, and both lids sit flush (top lid with the rim top, bottom lid with the body's outer faces) | assembly `intersection()` empty + echo of the outlines |

## 10. Assembly order (informative)

1. Press all inserts (body, divider, sockets/IEC bosses).
2. Snap the switches into the front. Screw the IEC inlet and sockets to the back. Fit the jack.
3. Divider module: relay board and adapter (2 × M3 × 30) underneath, Pi standoffs + Pi on top. Route the GPIO and USB-C cables through the feed-through.
4. Wire the high-voltage part, then lower the divider module from the top onto the pads and screw it down.
5. Bottom lid (lip into the walls), feet, top lid (into the rim).

## 11. Revision history

| Version | Date | Change |
|---|---|---|
| 0.0 | 2026-10-19 | template |
| 0.1 | 2026-10-19 | first full draft from requirements (round 1 + 2) |
| 0.2 | 2026-10-19 | review round 3: Pi and relay board **stacked** (relay standoffs 6 → 10 mm, new positions), adapter moved **from the bottom lid to the divider underside** (F31 → F14), bottom lid now a plain plate, feed-through moved between stack and adapter, jack wall thinned to 2 mm (P28), sections B-B and C-C added |
| 0.3 | 2026-10-19 | review round 4: **interlocking lid joints** (R22): top rebate with 1.5 mm rim (F15) + pry notch (F16), top lid inset 186.6 × 156.6 (F20), bottom lid locating lip 2 × 4 (F33). Body 120 → 123 high (overall height unchanged). Compartments renamed **low-voltage part** / **high-voltage part**, parameters `mains_h`/`rpi_h` → `hv_h`/`lv_h`. Detail drawing X/Y added. C7 bezel in the front view 26 → 26.7 (scaled from the original drawing) |
| 0.4 | 2026-10-19 | modeling corrections: F14 cable-tie lugs → **tie slots through the plate** (a tie can't pass between the adapter and the plate), P30 adapter screw → through-hole + nut (a boss would lift the adapter), P25/F6 IEC cutout corners r4 → **r1** (inlet body has r1 corners) |
| 0.5 | 2026-10-22 | review round 6: back panel order aligned with the front (seen from the top, left to right: mains, boiler, pump): IEC inlet x 155 → **35**, BOILER socket 100 → **90**, PUMP socket 45 → **145**, jack 155 → **35** (stays above the inlet). Front unchanged |
| 0.6 | 2026-10-22 | review round 7: label **BOILER → HEATER** on the front switch and the back socket (F3, F5, F7, F8) |
| 0.7 | 2026-10-22 | review round 8: **feet markings** on the bottom lid: 4 pockets Ø13 × 0.6 (F32, P33), bottom view drawing added |
| 0.8 | 2026-10-22 | review round 9: feet markings **removed again** (F32 back to positions only, P33 and the bottom view drawing removed) |
| 0.9 | 2026-10-23 | round 10 **measurements**: relay board 75 × 52, holes 70 × 46 (F12); adapter 51 × 49 × 27 with M3 × 30 screw + nut (F14, P30), ties optional; jack M8: Ø8 flat-top teardrop, wall 1.6 (F8, P27, P28); switch walls MAIN 3.7 (frame) / HEATER, PUMP 2.7 (pocket) (F3, P10); inserts 3 × 6 × 4.5 → holes Ø4.0 × 7 (P11); **M3 inserts only**: Pi on M2.5 nuts in hex pockets (F11, P12) |
| 0.10 | 2026-10-23 | review round 11: **M2.5 inserts 2.5 × 5 × 3.5 for the PCBs** (Pi, relay board) (P12, F11, F12), M3 inserts for the rest; Pi nut pockets removed; Pi bosses Ø7 × 3.5 under the plate |
| 0.11 | 2026-10-23 | review round 13: the adapter has **two** diagonal mounting holes → **2 standoffs Ø8 × 6 with M3 inserts**, 2 × M3 × 30 (F14, P30, P34); corner brackets, tie slots and nut removed; adapter hangs 6 mm lower (37 mm free below) |
| 0.12 | 2026-10-23 | review round 14: **adapter holes corrected**. v0.9–v0.11 placed the pattern mirrored (top edge assumed at the back). Correct: port face down → top edge at the front → standoffs at (166, 64.5) and (131, 106.5) (F14, P30) |
| 0.13 | 2026-10-23 | review round 14 (re-measured): adapter holes 13 mm from the sides (not 8) → standoffs at **(161, 64.5)** and **(136, 106.5)**, 25 × 42 mm apart (F14, P30) |
| 0.14 | 2026-10-23 | review round 15: 2 solid **rest standoffs** at the other two corners of the adapter's hole rectangle, (136, 64.5) and (161, 106.5): the adapter rests on 4 points, 2 with inserts (F14) |
| 0.15 | 2026-10-23 | review round 16: **Pi turned 90°**, USB/Ethernet to the front with 52 mm free (F11, P13, R23); **relay board turned with it** and still directly under the Pi (F12, P17); fan position follows the SoC (F22) |
| 0.16 | 2026-10-23 | review round 17: Pi **centred front to back** (34.5 mm at the ports and at the SD card) (F11, P13, R23); relay board centred under it (F12, P17); fan position follows the SoC (F22) |
| 0.17 | 2026-10-23 | review round 17: Pi **turned 180°**: GPIO header to the outer (left) wall, power socket towards the feed-through, USB/Ethernet to the back, SD card to the front (F11, P13); front relay standoffs now merge with the Pi bosses (F12); fan position follows the SoC (F22) |
| 0.18 | 2026-10-23 | review round 18: relay board **back in its original orientation** (75 × 52) at (27, 54), mains terminals towards the sockets, more clearance (F12, P17) |
| 0.19 | 2026-10-27 | round 19, **new brand** (R24, B1, B2): labels in **Zilla Slab Bold** (F5, F8); logo → the brand's **stacked logo** (kettle mark above the name), **130 × 85.17, centred on the lid** at (95, 80), masks cut out (F21, P35); the optional fan cuts through it (F22); fine logo details noted in §8; AC8; top lid drawing added. The draft's side-by-side logo (B1, 170 wide at the front) was replaced before approval |
| 0.20 | 2026-11-04 | round 20, **print feedback**: jack hole too loose (thread 7.8, printed hole 8.5). Hole **Ø8.4 → Ø7.9**: `jack_d` 8 → 7.8 measured (P27), own clearance 0.05 per side (new P36) instead of P9 (F8, §6) |
| 0.21 | 2026-11-04 | round 20, **print feedback** change 2: rocker switch cutouts too small. MAIN 22 × 27 → **21 × 28.5** (height of the HEATER/PUMP cutout it fits in, 1 mm narrower), HEATER/PUMP 21.5 × 28.5 → **21.5 × 30** (+1.5 high) (P23, P24, F3). Clip walls (P10) unchanged |
