tinkerius/brewberrypi-case/04-stl/check-report.txt

# tools/check.sh output, 2026-11-04, model from spec v0.21

### AC1 / AC2: meshes and bounding boxes
== 04-stl/brewberrypi-case-body.stl
   Min X =  0.000000, Max X =  190.000000
   Min Y = -0.599999, Max Y =  160.600006
   Min Z =  0.000000, Max Z =  123.000000
   Number of facets                 : 17808               17808
   Number of parts       :     1        Volume   :  267810.062500
   Degenerate facets     :     0
   Edges fixed           :     0
   Facets removed        :     0
   Facets added          :     0
   Backwards edges       :     0
   Normals fixed         :     0
   ok
== 04-stl/brewberrypi-case-bottom_lid.stl
   Min X =  0.000000, Max X =  190.000000
   Min Y =  0.000000, Max Y =  160.000000
   Min Z =  0.000000, Max Z =  7.000000
   Number of facets                 :   780                 780
   Number of parts       :     1        Volume   :  95850.578125
   Degenerate facets     :     0
   Edges fixed           :     0
   Facets removed        :     0
   Facets added          :     0
   Backwards edges       :     0
   Normals fixed         :     0
   ok
== 04-stl/brewberrypi-case-divider.stl
   Min X =  3.300003, Max X =  186.699997
   Min Y =  3.300000, Max Y =  156.699997
   Min Z =  0.000000, Max Z =  13.000000
   Number of facets                 :  4896                4896
   Number of parts       :     1        Volume   :  87753.984375
   Degenerate facets     :     0
   Edges fixed           :     0
   Facets removed        :     0
   Facets added          :     0
   Backwards edges       :     0
   Normals fixed         :     0
   ok
== 04-stl/brewberrypi-case-top_lid.stl
   Min X =  1.699997, Max X =  188.300003
   Min Y =  1.699997, Max Y =  158.300003
   Min Z =  0.000000, Max Z =  3.799999
   Number of facets                 : 15992               15992
   Number of parts       :     1        Volume   :  89345.000000
   Degenerate facets     :     0
   Edges fixed           :     0
   Facets removed        :     0
   Facets added          :     0
   Backwards edges       :     0
   Normals fixed         :     0
   ok

### AC6: overhangs steeper than 45° (print orientation, not on the bed)
== 04-stl/brewberrypi-case-body.stl: 35 region(s) ≥ 5 mm², 190 tiny (175.2 mm² in total)
   sloped               area    82.4 mm²  x   21.3…  48.7  y  157.0… 160.0  z   53.7…  54.0
   flat (bridge/ledge)  area    79.2 mm²  x   29.3…  50.7  y    0.0…   3.7  z   54.5…  54.5
   flat (bridge/ledge)  area    59.1 mm²  x  104.0… 126.0  y    0.0…   2.7  z   55.2…  55.2
   flat (bridge/ledge)  area    59.1 mm²  x  139.1… 160.9  y    0.0…   2.7  z   55.2…  55.2
   flat (bridge/ledge)  area    40.1 mm²  x   83.3…  96.7  y  157.0… 160.0  z   62.0…  62.0
   flat (bridge/ledge)  area    40.1 mm²  x  138.3… 151.7  y  157.0… 160.0  z   62.0…  62.0
   flat (bridge/ledge)  area    26.2 mm²  x   21.3…  58.7  y    3.0…   3.7  z   17.6…  17.6
   flat (bridge/ledge)  area    21.9 mm²  x   96.0… 168.9  y    2.7…   3.0  z   63.2…  63.2
   sloped               area    18.0 mm²  x   29.2…  40.8  y  157.0… 158.4  z  103.6… 106.0
   flat (bridge/ledge)  area    12.5 mm²  x  181.0… 185.0  y  151.0… 155.0  z    7.0…   7.0
   flat (bridge/ledge)  area    12.5 mm²  x  181.0… 185.0  y    5.0…   9.0  z    7.0…   7.0
   flat (bridge/ledge)  area    12.5 mm²  x    5.0…   9.0  y  151.0… 155.0  z    7.0…   7.0
   flat (bridge/ledge)  area    12.5 mm²  x    5.0…   9.0  y    5.0…   9.0  z    7.0…   7.0
   sloped               area     7.0 mm²  x    0.0…   3.0  y   38.9…  41.1  z  109.6… 110.0
   sloped               area     7.0 mm²  x  187.0… 190.0  y   38.9…  41.1  z  109.6… 110.0
   sloped               area     7.0 mm²  x    0.0…   3.0  y   46.9…  49.1  z  109.6… 110.0
   sloped               area     7.0 mm²  x  187.0… 190.0  y   46.9…  49.1  z  109.6… 110.0
   sloped               area     7.0 mm²  x    0.0…   3.0  y   54.9…  57.1  z  109.6… 110.0
   sloped               area     7.0 mm²  x  187.0… 190.0  y   54.9…  57.1  z  109.6… 110.0
   sloped               area     7.0 mm²  x    0.0…   3.0  y   62.9…  65.1  z  109.6… 110.0
   sloped               area     7.0 mm²  x  187.0… 190.0  y   62.9…  65.1  z  109.6… 110.0
   sloped               area     7.0 mm²  x    0.0…   3.0  y   70.9…  73.1  z  109.6… 110.0
   sloped               area     7.0 mm²  x  187.0… 190.0  y   70.9…  73.1  z  109.6… 110.0
   sloped               area     7.0 mm²  x    0.0…   3.0  y   78.9…  81.1  z  109.6… 110.0
   sloped               area     7.0 mm²  x  187.0… 190.0  y   78.9…  81.1  z  109.6… 110.0
   sloped               area     7.0 mm²  x    0.0…   3.0  y   86.9…  89.1  z  109.6… 110.0
   sloped               area     7.0 mm²  x  187.0… 190.0  y   86.9…  89.1  z  109.6… 110.0
   sloped               area     7.0 mm²  x    0.0…   3.0  y   94.9…  97.1  z  109.6… 110.0
   sloped               area     7.0 mm²  x  187.0… 190.0  y   94.9…  97.1  z  109.6… 110.0
   sloped               area     7.0 mm²  x    0.0…   3.0  y  102.9… 105.1  z  109.6… 110.0
   sloped               area     7.0 mm²  x  187.0… 190.0  y  102.9… 105.1  z  109.6… 110.0
   sloped               area     7.0 mm²  x    0.0…   3.0  y  110.9… 113.1  z  109.6… 110.0
   sloped               area     7.0 mm²  x  187.0… 190.0  y  110.9… 113.1  z  109.6… 110.0
   sloped               area     7.0 mm²  x    0.0…   3.0  y  118.9… 121.1  z  109.6… 110.0
   sloped               area     7.0 mm²  x  187.0… 190.0  y  118.9… 121.1  z  109.6… 110.0
== 04-stl/brewberrypi-case-bottom_lid.stl: 0 region(s) ≥ 5 mm², 0 tiny (0.0 mm² in total)
== 04-stl/brewberrypi-case-divider.stl: 4 region(s) ≥ 5 mm², 3 tiny (2.4 mm² in total)
   flat (bridge/ledge)  area     8.0 mm²  x   90.9…  94.1  y  117.4… 120.6  z    6.0…   6.0
   flat (bridge/ledge)  area     8.0 mm²  x   41.9…  45.1  y  117.4… 120.6  z    6.0…   6.0
   flat (bridge/ledge)  area     8.0 mm²  x   90.9…  94.1  y   59.4…  62.6  z    6.0…   6.0
   flat (bridge/ledge)  area     8.0 mm²  x   41.9…  45.1  y   59.4…  62.6  z    6.0…   6.0
== 04-stl/brewberrypi-case-top_lid.stl: 0 region(s) ≥ 5 mm², 0 tiny (0.0 mm² in total)

### AC8: label and logo sizes (capitals ≥ 6 mm, raised 0.6 / logo 130 × 85.17 at (95, 80), raised 0.8)
   MAIN (front) capitals  6.05 mm   raised 0.60 mm
   HEATER (front) capitals  6.05 mm   raised 0.60 mm
   PUMP (front) capitals  6.14 mm   raised 0.60 mm
   POWER (back) capitals  6.23 mm   raised 0.60 mm
   HEATER (back) capitals  6.05 mm   raised 0.60 mm
   PUMP (back) capitals  6.14 mm   raised 0.60 mm
   TEMP (back) capitals  6.05 mm   raised 0.60 mm
   logo     130.00 x 85.17 mm, centre (95.00, 80.00)   raised 0.80 mm

### AC3 / AC10: collision check (must be empty)
   ok: no overlaps

### AC4 / AC5: dimensions as modelled
   F1 body 190 x 160 x 123, lid seat z = 120, divider 70…73
   F3 MAIN cutout [21.4, 28.9] at x = 40, z = 40, wall at the clips 3.7
   F3 HEATER cutout [21.9, 30.4] at x = 115, z = 40, wall at the clips 2.7
   F3 PUMP cutout [21.9, 30.4] at x = 150, z = 40, wall at the clips 2.7
   F6 IEC cutout [27.9, 31.9] r1 at x = 35, z = 38, screws 36 apart
   F7 HEATER socket Ø43.4 flat top at 24, at x = 90, z = 38, holes □38
   F7 PUMP socket Ø43.4 flat top at 24, at x = 145, z = 38, holes □38
   F8 jack Ø7.9 flat top at 4.7, wall 1.6, at x = 35, z = 98
   F14 adapter [51, 49, 27] at [123, 61] on 6 mm standoffs: inserts at [[161, 64.5], [136, 106.5]], solid at [[136, 64.5], [161, 106.5]]
   inserts: M3 hole [4, 7] (case), M2.5 hole [3.2, 6] (Pi, relay board)
   F11 Pi holes [[92.5, 41], [43.5, 41], [92.5, 99], [43.5, 99]]
   F12 relay holes [[29.5, 57], [29.5, 103], [99.5, 57], [99.5, 103]]
   F21 logo 130 x 85.17 centred at [95, 80], raised 0.8
