tinkerius/brewberrypi-case/01-requirements/inputs/sketch-01-sectional-view.jpg

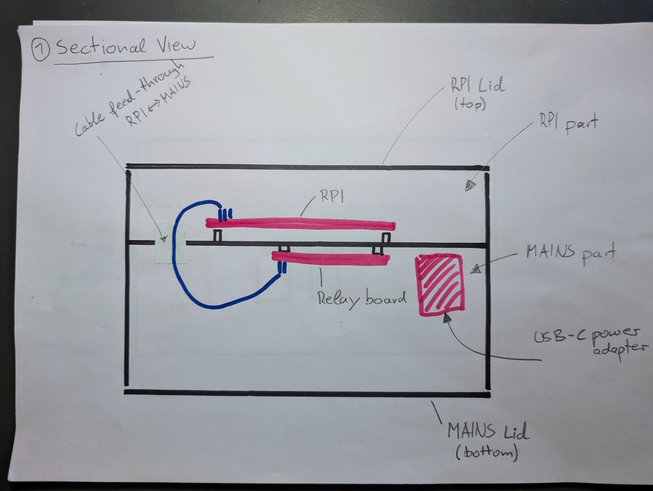
01-requirements/inputs/sketch-01-sectional-view.jpg
