tinkerius/brewberrypi-case/01-requirements/inputs/sketch-02-front-view.jpg

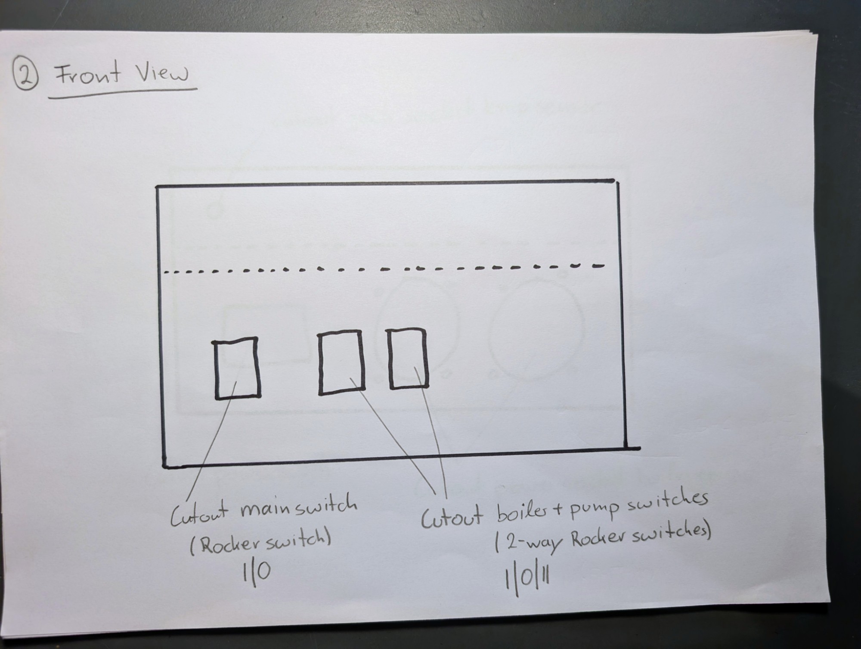
01-requirements/inputs/sketch-02-front-view.jpg
