tinkerius/brewberrypi-case/01-requirements/inputs/sketch-03-back-view.jpg

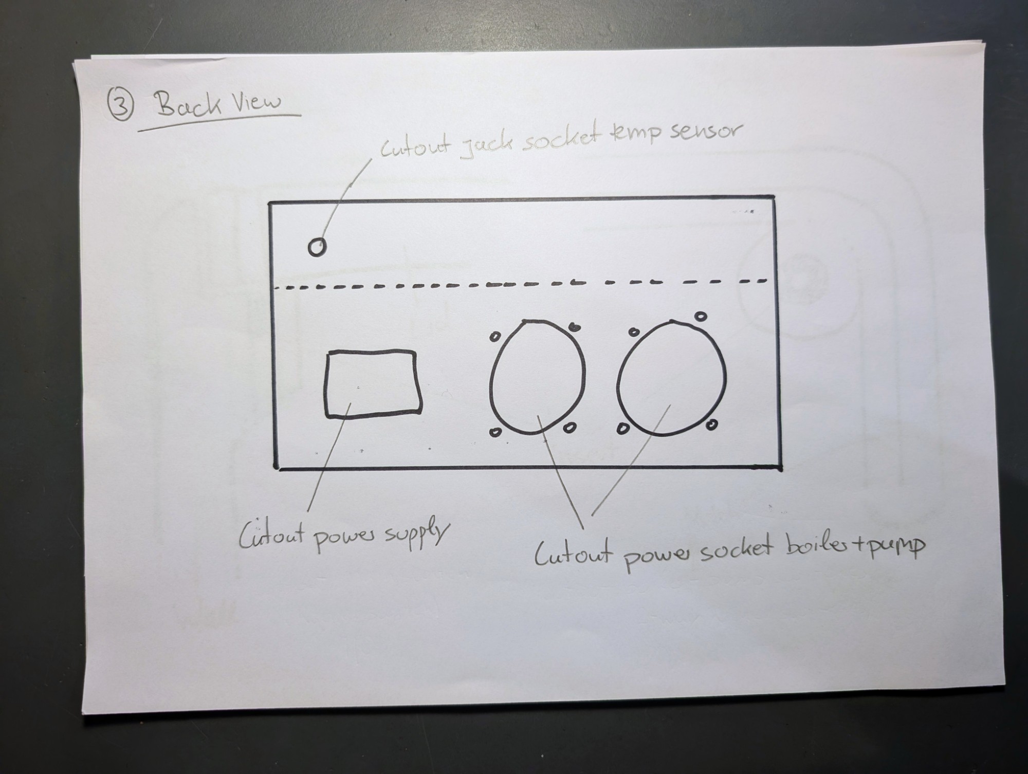
01-requirements/inputs/sketch-03-back-view.jpg
