tinkerius/brewberrypi-case/01-requirements/inputs/component-C1-relay-board.png

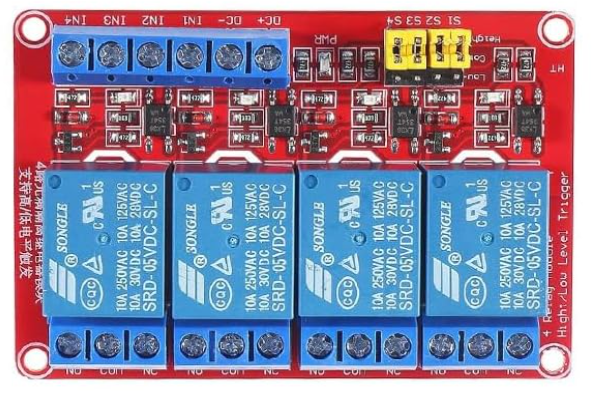
01-requirements/inputs/component-C1-relay-board.png
