tinkerius/brewberrypi-case/01-requirements/inputs/component-C2-usb-c-adapter-holes.png

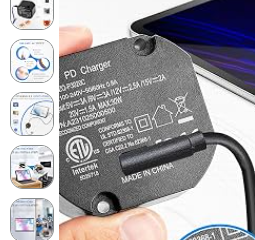
01-requirements/inputs/component-C2-usb-c-adapter-holes.png
