tinkerius/brewberrypi-case/01-requirements/inputs/component-C3-jack-socket.png

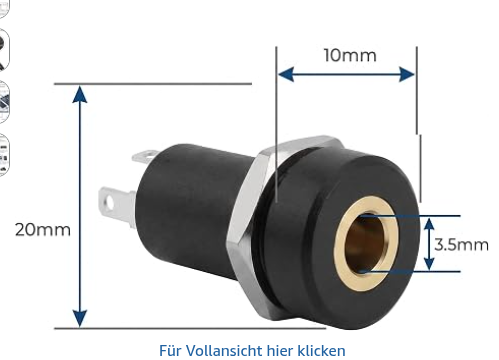
01-requirements/inputs/component-C3-jack-socket.png
