tinkerius/brewberrypi-case/01-requirements/inputs/component-C4-iec-inlet.png

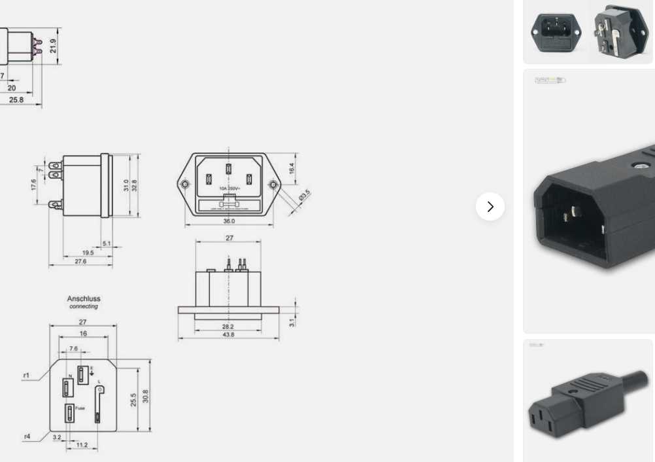
01-requirements/inputs/component-C4-iec-inlet.png
