tinkerius/brewberrypi-case/01-requirements/inputs/component-C5-power-socket.png

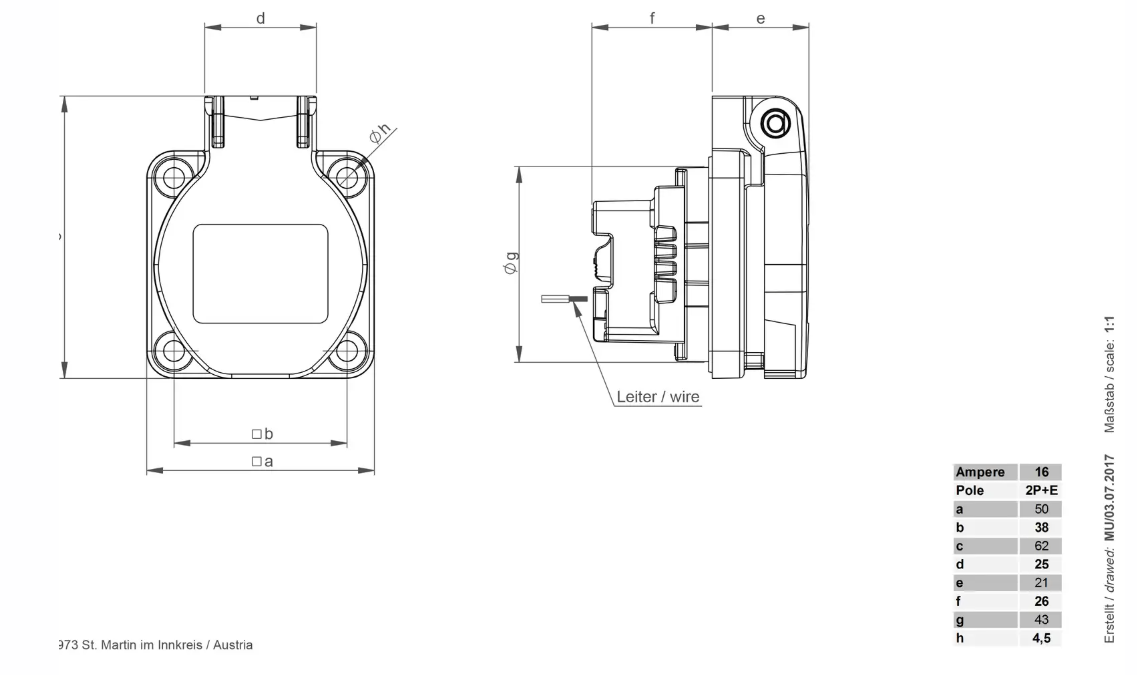
01-requirements/inputs/component-C5-power-socket.png
