tinkerius/brewberrypi-case/01-requirements/inputs/component-C6-rocker-switch-2pos.png

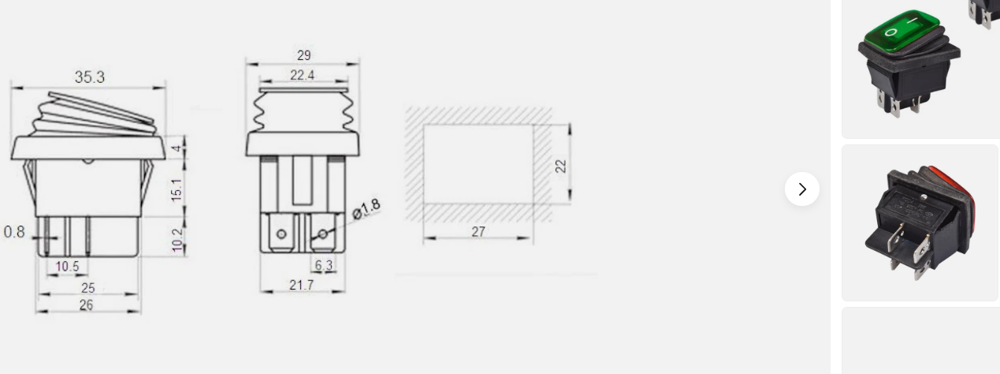
01-requirements/inputs/component-C6-rocker-switch-2pos.png
