tinkerius/brewberrypi-case/01-requirements/inputs/component-C7-rocker-switch-3pos.png

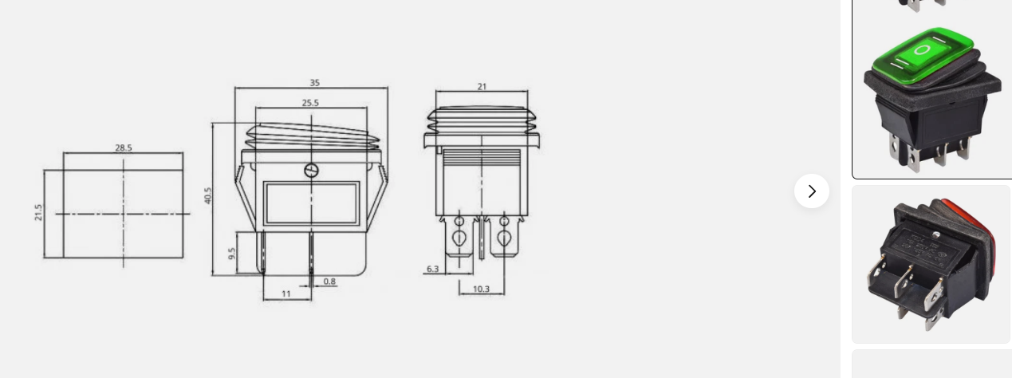
01-requirements/inputs/component-C7-rocker-switch-3pos.png
