tinkerius/brewberrypi-case/04-stl/brewberrypi-case-body.stl

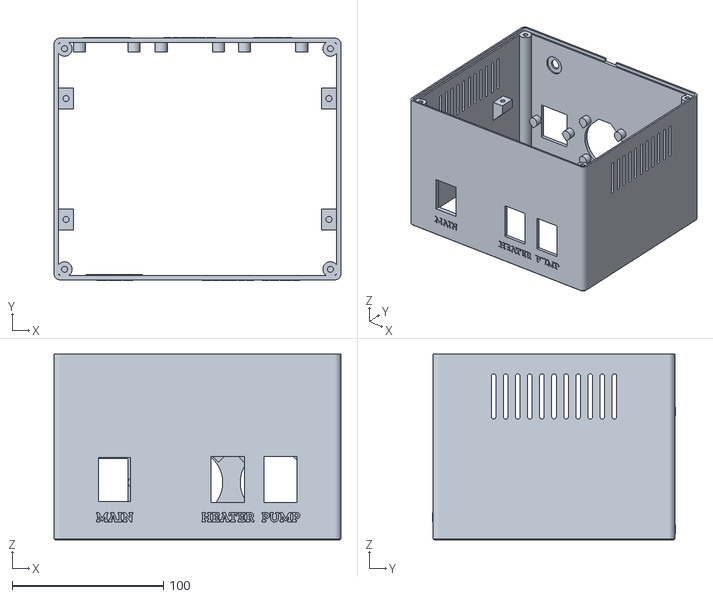
[picture p32: CAD file, 2026-11-04]
04-stl/brewberrypi-case-body.stl
190.0 x 161.2 x 123.0
