tinkerius/brewberrypi-case/04-stl/brewberrypi-case-top_lid.stl

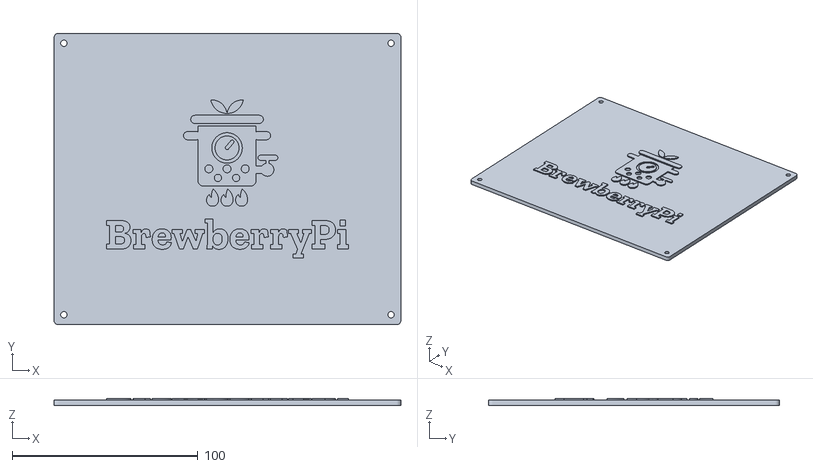
[picture p33: CAD file, 2026-10-27]
04-stl/brewberrypi-case-top_lid.stl
186.6 x 156.6 x 3.80
