tinkerius/brewberrypi-case/04-stl/brewberrypi-case-divider.stl

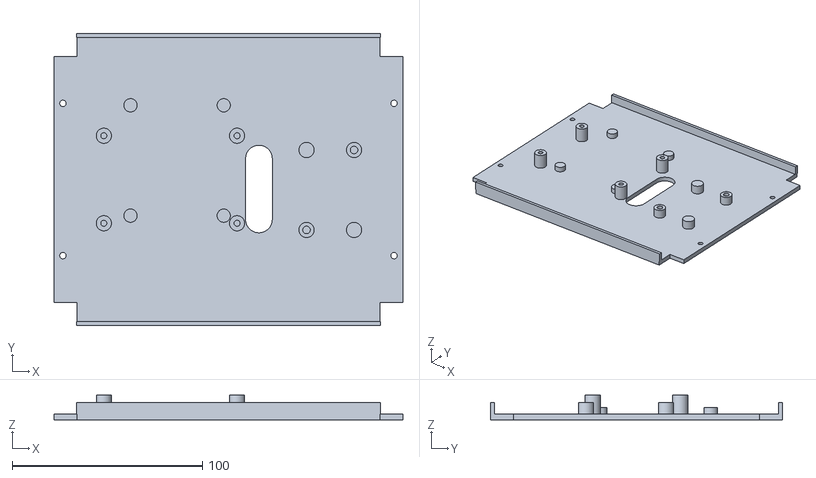
[picture p34: CAD file, 2026-10-23]
04-stl/brewberrypi-case-divider.stl
183.4 x 153.4 x 13.0
