tinkerius/brewberrypi-case/04-stl/brewberrypi-case-bottom_lid.stl

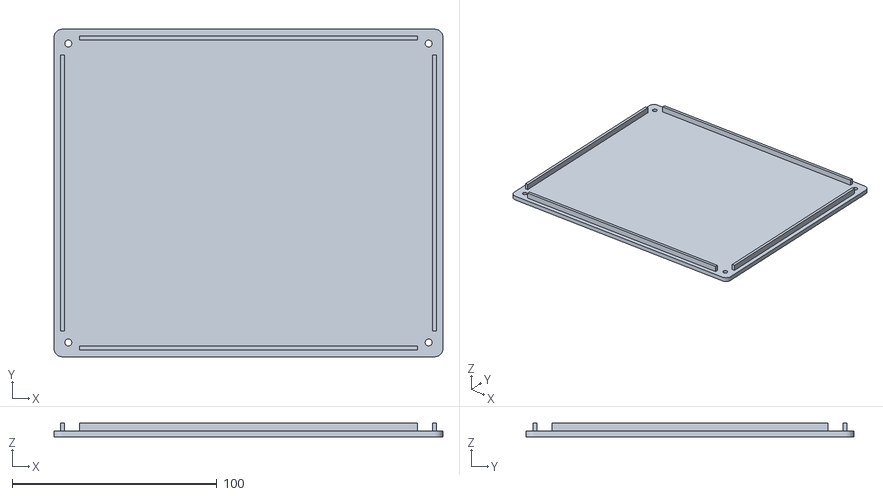
[picture p35: CAD file, 2026-10-23]
04-stl/brewberrypi-case-bottom_lid.stl
190.0 x 160.0 x 7.00
