tinkerius/brewberrypi-case/(commit log)

2026-10-19 Project scaffold: requirements → spec → OpenSCAD → STL pipeline
    Stage folders with templates, CLAUDE.md process rules, printer-agnostic
    FDM design rules, fdm.scad helpers, BOSL2 submodule, build/check/setup
    scripts and a SessionStart hook for cloud sessions.
    Claude-Session: https://claude.ai/code/session_01ADLbwL9wygVHDgYvXJAMiD
    [brewberrypi-case.scad]
2026-10-19 req: log round-2 answers, close requirements stage
    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
2026-10-19 spec: v0.2, stack Pi over relay board, adapter on divider underside
    Review round 3: relay standoffs 6 -> 10 mm so the Pi and relay board can be
    stacked as in sketch S1; USB-C adapter moved from the bottom lid to the
    divider next to the relay board; bottom lid now a plain plate; jack wall
    thinned to 2 mm; section B-B added. Jack picture stored as C3 input.
    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
2026-10-19 spec: v0.3, interlocking lid joints, rename compartments
    Review round 4: top lid sits in a rebate inside a 1.5 mm rim (F15) with a
    pry notch (F16); bottom lid gets a 2 x 4 mm locating lip (F33). Body is
    123 mm high, overall height unchanged. RPI/MAINS part renamed to
    low-voltage/high-voltage part. New detail drawing for both joints.
    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
2026-10-19 req: store original pictures of relay board (C1) and USB-C adapter (C2)
    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
2026-10-19 req: store original drawings of socket (C5) and rocker switches (C6, C7)
    All component inputs are now stored as files. C7 bezel short side scaled
    from its drawing (about 26.7 mm), front-view outline updated.
    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
    [make_drawings.py]
2026-10-19 spec: v0.4 modeling corrections (tie slots, adapter screw hole, IEC cutout r1)
    Found while preparing the OpenSCAD model: cable-tie lugs cannot hold the
    adapter (no path between adapter and plate) -> slots through the plate;
    an adapter screw boss would lift the adapter -> through-hole + nut; the
    IEC inlet body has r1 corners -> cutout corners r1 instead of r4.
    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
    [make_drawings.py]
2026-10-19 spec: correct the viewing direction in the A-A and B-B titles (+X)
    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
    [make_drawings.py]
2026-10-19 scad: OpenSCAD model from spec v0.4
    Entry file brewberrypi-case.scad with all spec parameters (Customizer) and a
    part selector (assembly, body, divider, top_lid, bottom_lid,
    collision_check); one module per spec feature in parts/*.scad, bought
    components as envelopes. Single parts come out in print orientation.
    Checked: all four parts render as single manifold meshes with the spec
    sizes, the collision check (AC3/AC10) renders empty, the dimension
    report matches spec section 5. Back panel bosses got a teardrop cross
    section so their 45-degree underside stays clear of the socket bodies.
    build.sh and README updated to the new part names.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
    [body.scad, brewberrypi-case.scad, components.scad, divider.scad, lids.scad]
2026-10-19 spec: v0.4 confirmed by the user; tools: binary STL export, overhang report, full AC check
    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
2026-10-19 scad: label/logo text size so capitals reach the specified 6 / 12 mm
    OpenSCAD renders Liberation Sans Bold slightly smaller than the size
    given (measured 5.7-5.9 mm caps at size 6, 11.5 mm at 12). Sizes 6.4 and
    12.6 give 6.1-6.3 mm and 12.0 mm. tools/labels.py measures this on the
    STLs and is now part of tools/check.sh (AC8).
    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
    [brewberrypi-case.scad]
2026-10-19 stl: build STLs and previews from spec v0.4, verification table
    Four binary STLs in print orientation (body, divider, top lid, bottom
    lid), 20 preview PNGs and the full tools/check.sh output. AC1-AC8 and
    AC10 pass; AC9 (print test) is open.
    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
    [brewberrypi-case-body.stl, brewberrypi-case-bottom_lid.stl, brewberrypi-case-divider.stl, brewberrypi-case-top_lid.stl]
2026-10-22 spec: v0.5, back panel order aligned with the front (mains, boiler, pump)
    Review round 6: seen from the top, left to right, both panels now read
    mains, boiler (heater), pump. Back panel mirrored: IEC inlet x 35,
    BOILER socket 90, PUMP socket 145; the jack moves with the inlet to x 35.
    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
2026-10-22 scad: back panel in the order mains, boiler, pump (spec v0.5)
    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
    [brewberrypi-case.scad]
2026-10-22 stl: rebuild from spec v0.5, all automated checks pass
    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
    [brewberrypi-case-body.stl, brewberrypi-case-bottom_lid.stl, brewberrypi-case-divider.stl, brewberrypi-case-top_lid.stl]
2026-10-22 spec: v0.6, label BOILER -> HEATER (front switch, back socket)
    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
2026-10-22 scad: label HEATER instead of BOILER (spec v0.6)
    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
    [brewberrypi-case.scad]
2026-10-22 stl: rebuild body and assembly previews from spec v0.6, all automated checks pass
    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
    [brewberrypi-case-assembly.stl, brewberrypi-case-body.stl]
2026-10-22 scad: feet marking pockets on the bottom lid (spec v0.7, F32/P33)
    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
    [brewberrypi-case.scad, lids.scad]
2026-10-22 stl: rebuild bottom lid and assembly previews from spec v0.7, all automated checks pass
    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
    [brewberrypi-case-assembly.stl, brewberrypi-case-bottom_lid.stl]
2026-10-22 scad: remove the feet marking pockets again (spec v0.8)
    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
    [brewberrypi-case.scad, lids.scad]
2026-10-22 stl: rebuild bottom lid and assembly previews from spec v0.8, all automated checks pass
    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
    [brewberrypi-case-assembly.stl, brewberrypi-case-bottom_lid.stl]
2026-10-23 req: round 10, measured relay board and USB-C adapter
    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
2026-10-23 req: round 10, measured rocker switches
    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
2026-10-23 req: round 10, measured switch bodies
    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
2026-10-23 spec: v0.9 with the measured parts (round 10)
    Relay board 75 x 52 / holes 70 x 46; USB-C adapter 51 x 49 x 27 fixed
    with an M3 x 30 screw + nut (ties optional); jack M8 with a flat-top
    teardrop and 1.6 mm wall; switch walls 3.7 (MAIN, frame) and 2.7 mm
    (HEATER/PUMP, pocket) from the clip gaps; inserts 3 x 6 x 4.5 -> holes
    4.0 x 7; M3 inserts only: Pi standoffs on M2.5 nuts in hex pockets.
    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
    [make_drawings.py]
2026-10-23 scad: model with the measured parts (spec v0.9)
    Relay board 75 x 52 / 70 x 46 and its 17 + 3 mm envelope; adapter 51 x 49
    with screw hole; jack M8 flat-top teardrop, wall 1.6; per-switch wall at
    the clips (MAIN frame 3.7, HEATER/PUMP pocket 2.7); insert holes 4.0 x 7;
    Pi standoffs on M2.5 nuts in hex pockets (M3 inserts only).
    build.sh: STLs only for printable parts (assembly = previews only).
    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
    [body.scad, brewberrypi-case-assembly.stl, brewberrypi-case.scad, components.scad, divider.scad]
2026-10-23 stl: rebuild all parts from spec v0.9, all automated checks pass
    Also removes brewberrypi-case-assembly.stl, which was exported by mistake
    with the v0.6 preview rebuild (not a printable part).
    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
    [brewberrypi-case-body.stl, brewberrypi-case-bottom_lid.stl, brewberrypi-case-divider.stl, brewberrypi-case-top_lid.stl]
2026-10-23 spec: v0.10, M2.5 inserts for the circuit boards, M3 for the rest
    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
2026-10-23 scad: M2.5 inserts for the Pi and the relay board, nut pockets removed (spec v0.10)
    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
    [brewberrypi-case.scad, divider.scad]
2026-10-23 stl: rebuild body, divider and assembly previews from spec v0.10, all automated checks pass
    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
    [brewberrypi-case-body.stl, brewberrypi-case-divider.stl]
2026-10-23 req: round 12, jack position and M3 insert size confirmed
    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
2026-10-23 spec: v0.11, adapter on 2 standoffs with M3 inserts at its two diagonal holes
    Brackets, tie slots and nut removed; 2 x M3 x 30 from below. New input
    photo showing the adapter's two mounting holes.
    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
2026-10-23 scad: adapter on 2 standoffs with M3 inserts, brackets/tie slots/nut removed (spec v0.11)
    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
    [brewberrypi-case.scad, components.scad, divider.scad]
2026-10-23 stl: rebuild divider and assembly previews from spec v0.11, all automated checks pass
    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
    [brewberrypi-case-divider.stl]
2026-10-23 spec: v0.12, adapter holes corrected (pattern was mirrored)
    Port face down with the cable side towards -X puts the port face's top
    edge at the front, so the holes are at front-right (166, 64.5) and
    back-left (131, 106.5). v0.9-v0.11 had them on the other diagonal.
    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
    [make_drawings.py]
2026-10-23 scad+stl: adapter holes on the correct diagonal (spec v0.12); hole spacing still open
    The divider now has the adapter standoffs at front-right / back-left.
    Their spacing (54.7 mm) does not match the real adapter (48.5 mm, user);
    re-measurement requested. Marked in spec, requirements, README and
    04-stl/README: do not print the divider until this is fixed.
    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
    [brewberrypi-case-divider.stl, brewberrypi-case.scad]
2026-10-23 spec: v0.13, adapter holes re-measured (13 mm from the sides, 25 x 42 apart)
    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
2026-10-23 scad: adapter standoffs at the re-measured holes, 25 x 42 apart (spec v0.13)
    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
    [brewberrypi-case.scad]
2026-10-23 stl: rebuild divider from spec v0.13, all automated checks pass; divider hold lifted
    Standoff positions verified in the STL: (161, 64.5) and (136, 106.5),
    25 x 42 mm apart, 48.9 mm diagonal (measured 48.5).
    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
    [brewberrypi-case-divider.stl]
2026-10-23 spec: v0.14, two solid rest standoffs for the adapter (4-point support)
    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
2026-10-23 scad: two solid rest standoffs for the adapter (spec v0.14)
    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
    [brewberrypi-case.scad, divider.scad]
2026-10-23 stl: rebuild divider from spec v0.14, all automated checks pass
    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
    [brewberrypi-case-divider.stl]
2026-10-23 spec: v0.15, Pi turned 90 degrees (USB/Ethernet to the front), relay board turned with it
    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
2026-10-23 scad: Pi and relay board turned 90 degrees, USB/Ethernet to the front (spec v0.15)
    Collision check now also keeps 40 mm free in front of the Pi's ports (R23).
    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
    [brewberrypi-case.scad, components.scad]
2026-10-23 stl: rebuild divider and previews from spec v0.15, all automated checks pass
    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
    [brewberrypi-case-divider.stl]
2026-10-23 spec: v0.17, Pi turned 180 degrees: GPIO to the outer wall, power towards the feed-through
    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
2026-10-23 scad: Pi centred front to back and turned (GPIO at the outer wall), relay board centred under it (spec v0.16/v0.17)
    Collision check keeps 30 mm free at the SD card (front) and the
    USB/Ethernet ports (back).
    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
    [brewberrypi-case.scad, components.scad]
2026-10-23 stl: rebuild divider and previews from spec v0.17, all automated checks pass
    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
    [brewberrypi-case-divider.stl]
2026-10-23 spec: v0.18, relay board back in its original orientation
    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
2026-10-23 scad: relay board back in its original orientation (spec v0.18)
    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
    [brewberrypi-case.scad]
2026-10-23 stl: rebuild divider and previews from spec v0.18, all automated checks pass
    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
    [brewberrypi-case-divider.stl]
2026-10-26 ci: script-first build (Makefile, VS Code tasks, devcontainer CI) and pipeline gates
    - Makefile is the single source of truth: setup, build, lint, test, ci, status,
    plus claude-scad / claude-stl / pipeline to run the headless stages via `claude -p`.
    - lint: shellcheck, ruff (errors only), every OpenSCAD part evaluated with
    --hardwarnings, spec drawings regenerate unchanged, version stamps agree.
    - tools/status.py reads the spec version stamps of each stage and reports
    done / stale / needs-you; build.sh records the .scad source hash in
    04-stl/.source-hash after a full build.
    - .devcontainer (Ubuntu 24.04, OpenSCAD 2021.01, admesh, xvfb, shellcheck, ruff),
    .vscode/tasks.json and .git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
    [status.py]
2026-10-26 docs: one skill per pipeline stage, CLAUDE.md points to make status
    The per-stage instructions move from CLAUDE.md into .claude/skills/
    (requirements, spec, scad, stl, feedback), each with inputs, outputs, steps,
    exit gate and human gate. CLAUDE.md keeps the pipeline overview and the rules.
    README gets a pipeline table and the make targets.
    Claude-Session: https://claude.ai/code/session_011S9wGSnx3JrJfegM2MUaSs
2026-10-26 ci: drop the STL artifact upload (quota; STLs are committed), checkout v5
    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
2026-10-27 spec: v0.19 draft, new brand: Zilla Slab Bold labels, brand logo on the top lid
    F5/F8: labels in Zilla Slab Bold, same size and positions.
    F21/P35: the brand's one-colour logo (kettle mark + name, B1),
    170 x 34.85 at (95, 30), mask parts cut out. §8 notes the logo's
    sub-millimetre details. AC8 updated. New drawing top-lid.svg embeds
    B1 at its spec size. Waiting for approval.
    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
2026-10-27 spec: v0.19 approved, stacked brand logo centred on the top lid
    F21/P35: the brand's stacked logo (B2), 130 x 85.17, centred at
    (95, 80), one colour, mask parts cut out. F22: the optional fan
    opening cuts through it. §8: finest logo details 0.77-0.98 mm.
    AC8 updated. top-lid.svg shows B2 in one colour with the fan
    outline over it. Approved by the user in the session.
    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
2026-10-27 scad: brand typeface and stacked brand logo (spec v0.19)
    Labels (F5, F8) in Zilla Slab Bold, shipped in 03-openscad/fonts/
    with its SIL OFL licence; size 6.7 gives 6.05 mm capitals.
    F21: tools/make_logo.py flattens the brand file B2 (SVG with masks)
    into lib/brand-logo.scad; the lid scales it to logo_w = 130 (P35)
    and centres it at (95, 80). A 0.01 closing joins the two leaf lobes,
    which only touch at a point and otherwise break the CGAL union.
    Tooling: make lint-logo keeps the generated file in sync, the STL
    source hash includes the font, labels.py measures the logo box.
    Claude-Session: https://claude.ai/code/session_01ADLbwL9wygVHDg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
    [brewberrypi-case.scad, lids.scad]
2026-10-27 stl: rebuild body, top lid and previews from spec v0.19, all automated checks pass
    Labels in Zilla Slab Bold (capitals 6.05-6.23 mm, raised 0.6), stacked
    brand logo 130.00 x 85.17 centred at (95.00, 80.00), raised 0.8; its
    outline matches B2 to 0.15 % of pixels. Meshes manifold, collision
    check empty. Divider and bottom lid unchanged. AC9 print test open.
    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
    [brewberrypi-case-body.stl, brewberrypi-case-top_lid.stl]
2026-11-04 req: round 20, print feedback: jack hole too loose (A2)
    Jack thread measured 7.8 mm; the printed hole (Ø8.4 in the model)
    came out 8.5. The user asks for a hole 0.5 mm smaller.
    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
2026-11-04 spec: v0.20, jack hole Ø8.4 -> Ø7.9 (print feedback, round 20)
    P27 jack_d 8 -> 7.8 (measured thread), new P36 jack_clearance 0.05
    per side instead of P9: the Ø8.4 hole printed at 8.5 and was loose.
    F8, §6 and the back view updated. Requested by the user.
    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
    [make_drawings.py]
2026-11-04 scad: jack hole Ø7.9, thread 7.8 + own clearance 0.05 per side (spec v0.20)
    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
    [body.scad, brewberrypi-case.scad]
2026-11-04 stl: rebuild body from spec v0.20, jack hole Ø7.9, all automated checks pass
    Measured on the STL: 7.90 wide, flat top 4.70 above the centre.
    Divider and lids unchanged. AC9 records the first print: jack hole
    printed 8.5 for the 7.8 thread; reprint the body.
    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
    [brewberrypi-case-body.stl]
2026-11-04 req: round 20 change 2, rocker switch cutouts too small (C6, C7)
    MAIN 22 x 27 -> 21 x 28.5 (fits the HEATER/PUMP height, 1 mm too
    wide), HEATER/PUMP 21.5 x 28.5 -> 21.5 x 30 (1.5 mm higher).
    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
2026-11-04 spec: v0.21, rocker switch cutouts from the print test (round 20)
    MAIN 22 x 27 -> 21 x 28.5, HEATER/PUMP 21.5 x 28.5 -> 21.5 x 30
    (P23, P24, F3, front view). Requested by the user.
    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
2026-11-04 scad: rocker switch cutouts MAIN 21 x 28.5, HEATER/PUMP 21.5 x 30 (spec v0.21)
    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
    [brewberrypi-case.scad]
2026-11-04 stl: rebuild body from spec v0.21, new rocker switch cutouts, all automated checks pass
    Measured on the STL: MAIN 21.40 x 28.90, HEATER/PUMP 21.90 x 30.40.
    Divider and lids unchanged. AC9 records both print findings.
    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
    [brewberrypi-case-body.stl]
